gamarrita/fmc-320u-public/altium/FMC-320U-A2/pcbway/comercial invoice/readme.txt

La proforma final tal cual se puede descargar de pcbway, con la que se hizo el pago
