gamarrita/fmc-320u-public/altium/FMC-320U-A2/pcbway/quotations/Quotation T-M10W373821A-2sets-fmc-320-u-a1+-+bom(2023-11-03).xls

PCBWay Bom Quotation, Product No.:T-M10W373821A
Item # | *Designator | *Qty | Manufacturer | *Mfg Part # | Description / Value | *Package/Footprint | Mounting Type | Substitute | *Unit Price(2 sets) | *Total | *Delivery Time | *PCBWay Note | Customer Reply | PCBWay Update
1 | C1, C2, C3, C4, C5, C6, C7, C9, C10, C11, C12, C13, C15, C22 | 14 | Yageo | CC0805KRX7R8BB104 | 100nF | 0805 | Surface Mount, MLCC | CC0805KRX7R9BB104 | $0.015 | $0.420
2 | C8, C19, C23, C24 | 4 | Yageo | CC0805KKX5R8BB106 | 10uF | 0805 | Surface Mount, MLCC |  | $0.084 | $0.672
3 | C14, C17, C18 | 3 | Yageo | CC0805KKX7R8BB225 | 2.2uF | 0805 | Surface Mount, MLCC |  | $0.066 | $0.396
4 | C16 | 1 | Yageo | CC0805KKX7R8BB105 | 1uF | 0805 | Surface Mount, MLCC |  | $0.084 | $0.168
5 | C20, C21 | 2 | Yageo | CC0805JRNPO9BN120 | 12pF | 0805 | Surface Mount, MLCC |  | $0.050 | $0.200
6 | CN1 | 1 | Amphenol ICC | 54101-T0605LF |  |  |  |  | $0.427 | $0.854 | 7-10 Workdays
7 | CN2 | 1 | Dealon | DW254R-22-20-85 |  |  |  |  | $0.677 | $1.354
8 | CN3 | 1 | Dealon | DW254S-22-10-85 |  |  |  |  | $0.715 | $1.430
9 | CN4 | 1 | Amphenol ICC | 20021511-00014T4LF |  |  |  |  | $2.214 | $4.428
10 | ESD1, ESD2, ESD3 | 3 | ST | ESDALC6V1W5 |  |  | Surface Mount |  | $0.339 | $2.034
11 | J3 | 1 | Ckmtw | B-2100S08P-B110 |  |  |  |  | $0.341 | $0.682
12 | L1 | 1 | Murata Electronics | LQM21PN2R2MGHL | 2.2uH |  | Surface Mount |  | $0.252 | $0.504
13 | LD1 | 1 | Everlight Elec | 17-21SYGC/S530-E2/TR8 |  |  |  |  | $0.064 | $0.128
14 | LD2 | 1 | Everlight Elec | 17-21SYGC/S530-E2/TR8 |  |  |  |  | $0.064 | $0.128
15 | LD3 | 1 | Everlight Elec | 17-21/BHC-XL2M2TY/3T |  |  |  |  | $0.093 | $0.186
16 | LSE1 | 1 | Seiko | SC32S-12.5PF20PPM | 32,768 kHz |  |  |  | $0.686 | $1.372 | 7-10 Workdays
17 | PTH1, PTH2, PTH3, PTH4 | 4 |  |  |  |  |  |  |  |  |  | [DNP不要贴];
18 | Q1 | 1 | Diodes Incorporated | DMG3401LSN-7 |  |  | Surface Mount |  | $0.341 | $0.682
19 | R1, R2, R3, R4, R5, R6, R7, R8 | 8 | Yageo | RC0805FR-07100KL | 100K | 0805 |  |  | $0.018 | $0.288
20 | R9 | 1 | Yageo | RC0805FR-071ML | 1M | 0805 |  |  | $0.143 | $0.286
21 | R10, R13, R14, R15, R16, R17, R18, R19 | 8 | Yageo | RC0805FR-0747RL | 47R | 0805 |  |  | $0.017 | $0.272
22 | R11 | 1 | Yageo | RC0805FR-07100RL | 100R | 0805 |  |  | $0.136 | $0.272
23 | R12 | 1 | Yageo | RC0805FR-0710KL | 10K | 0805 |  |  | $0.136 | $0.272
24 | R22, R23, R24 | 3 | Yageo | RC0805FR-071KL | 1K | 0805 |  |  | $0.048 | $0.288
25 | SW1, SW2, SW3, SW4 | 4 | XKB Connectivity | TC-1102-B-A-B |  |  |  |  | $0.099 | $0.792
26 | U1 | 1 | NXP | PCF8553DTT/AY |  |  | Surface Mount |  | $1.284 | $2.568 | 15Workdays
27 | U2 | 1 | ST | STM32U575VIT6Q |  |  | Surface Mount |  | $15.121 | $30.242 | 7-10 Workdays
 |  |  |  |  |  |  |  |  | Component Cost | $50.92
 |  |  |  |  |  |  |  |  | Assembly Cost | $30.00
 |  |  |  |  |  |  |  |  | PCB Cost | $5.00
 |  |  |  |  |  |  |  |  | V0 Member 0% off | $0.00
 |  |  |  |  |  |  |  |  | All Total 2 Sets | $85.92
