gamarrita/fmc-320u-public/altium/FMC-320U-A2/pcbway/quotations/Quotation T-M10W373821A-5sets-fmc-320-u-a1+-+bom(2023-11-02).xls

PCBWay Bom Quotation, Product No.:T-M10W373821A
Item # | *Designator | *Qty | Manufacturer | *Mfg Part # | Description / Value | *Package/Footprint | Mounting Type | Substitute | *Unit Price(5 sets) | *Total | *Delivery Time | *PCBWay Note | Customer Reply | PCBWay Update
1 | C1, C2, C3, C4, C5, C6, C7, C9, C10, C11, C12, C13, C15, C22 | 14 | Yageo | CC0805KRX7R8BB104 | 100nF | 0805 | Surface Mount, MLCC | CC0805KRX7R9BB104 | $0.015 | $1.050
2 | C8, C19, C23, C24 | 4 | Yageo | CC0805KKX5R8BB106 | 10uF | 0805 | Surface Mount, MLCC |  | $0.084 | $1.680
3 | C14, C17, C18 | 3 | Yageo | CC0805KKX7R8BB225 | 2.2uF | 0805 | Surface Mount, MLCC |  | $0.066 | $0.990
4 | C16 | 1 | Yageo | CC0805KKX7R8BB105 | 1uF | 0805 | Surface Mount, MLCC |  | $0.084 | $0.420
5 | C20, C21 | 2 | Yageo | CC0805JRNPO9BN120 | 12pF | 0805 | Surface Mount, MLCC |  | $0.050 | $0.500
6 | CN1 | 1 | Amphenol ICC | 54101-T0605LF |  |  |  |  | $0.427 | $2.135 | 7-10 Workdays
7 | CN2 | 1 | Dealon | DW254R-22-20-85 |  |  |  |  | $0.271 | $1.355
8 | CN3 | 1 | Dealon | DW254S-22-10-85 |  |  |  |  | $0.286 | $1.430
9 | CN4 | 1 | Amphenol ICC | 20021511-00014T4LF |  |  |  |  | $2.214 | $11.070
10 | ESD1, ESD2, ESD3 | 3 | ST | ESDALC6V1W5 |  |  | Surface Mount |  | $0.271 | $4.065
11 | J3 | 1 | Ckmtw | B-2100S08P-B110 |  |  |  |  | $0.341 | $1.705
12 | L1 | 1 | Murata Electronics | LQM21PN2R2MGHL | 2.2uH |  | Surface Mount |  | $0.252 | $1.260
13 | LD1 | 1 | Everlight Elec | 17-21SYGC/S530-E2/TR8 |  |  |  |  | $0.064 | $0.320
14 | LD2 | 1 | Everlight Elec | 17-21SYGC/S530-E2/TR8 |  |  |  |  | $0.064 | $0.320
15 | LD3 | 1 | Everlight Elec | 17-21/BHC-XL2M2TY/3T |  |  |  |  | $0.093 | $0.465
16 | LSE1 | 1 | Seiko | SC32S-12.5PF20PPM | 32,768 kHz |  |  |  | $0.686 | $3.430 | 7-10 Workdays
17 | PTH1, PTH2, PTH3, PTH4 | 4 |  |  |  |  |  |  |  |  |  | [DNP不要贴];
18 | Q1 | 1 | Diodes Incorporated | DMG3401LSN-7 |  |  | Surface Mount |  | $0.341 | $1.705
19 | R1, R2, R3, R4, R5, R6, R7, R8 | 8 | Yageo | RC0805FR-07100KL | 100K | 0805 |  |  | $0.007 | $0.280
20 | R9 | 1 | Yageo | RC0805FR-071ML | 1M | 0805 |  |  | $0.057 | $0.285
21 | R10, R13, R14, R15, R16, R17, R18, R19 | 8 | Yageo | RC0805FR-0747RL | 47R | 0805 |  |  | $0.007 | $0.280
22 | R11 | 1 | Yageo | RC0805FR-07100RL | 100R | 0805 |  |  | $0.055 | $0.275
23 | R12 | 1 | Yageo | RC0805FR-0710KL | 10K | 0805 |  |  | $0.054 | $0.270
24 | R22, R23, R24 | 3 | Yageo | RC0805FR-071KL | 1K | 0805 |  |  | $0.019 | $0.285
25 | SW1, SW2, SW3, SW4 | 4 | XKB Connectivity | TC-1102-B-A-B |  |  |  |  | $0.079 | $1.580
26 | U1 | 1 | NXP | PCF8553DTT/AY |  |  | Surface Mount |  | $1.284 | $6.420 | 15Workdays
27 | U2 | 1 | ST | STM32U575VIT6Q |  |  | Surface Mount |  | $15.121 | $75.605 | 7-10 Workdays
 |  |  |  |  |  |  |  |  | Component Cost | $119.18
 |  |  |  |  |  |  |  |  | Assembly Cost | $30.00
 |  |  |  |  |  |  |  |  | PCB Cost | $5.00
 |  |  |  |  |  |  |  |  | V0 Member 0% off | $0.00
 |  |  |  |  |  |  |  |  | All Total 5 Sets | $154.18
