gamarrita/fmc-320u-public/altium/FMC-320U-A2/pcbway/quotations/T-Z12W373821A-5sets-FMC-320U-A2+-+BOM(2023-11-09).xls

PCBWay Bom Quotation, Product No.:T-Z12W373821A
Item # | *Designator | *Qty | Manufacturer | *Mfg Part # | *Package/Footprint | Mounting Type | *Unit Price(5 sets) | *Total | *Delivery Time | *Actual Purchase Mfg Part # | *PCBWay Note | Customer Reply | PCBWay Update
1 | BH1 | 1 | Keystone Electronics | 2462 |  | PCB, Through Hole | $1.497 | $7.485
2 | BH2 | 1 | Myoung | BS-2032-8KC |  |  |  |  |  |  | It's out of stock. Please recommend substitutes or you can supply this part to us. | Use this: BS-08-B2AA016
3 | C1, C3, C17, C18, C20, C21 | 6 | Yageo | CC0805KRX7R9BB333, CC0805KRX5R6BB475 | 0805 |  | $0.029 | $0.870 |  | CC0805KRX7R9BB333 |  | Use this :CC0805KRX5R6BB475
4 | C2, C4, C9, C10, C12, C13, C14, C15, C16 | 9 | Yageo | CC0805KRX7R8BB104 | 0805 | Surface Mount, MLCC | $0.016 | $0.720
5 | C5 | 1 | Yageo | CC0805JRNPO9BN330 | 0805 | Surface Mount, MLCC | $0.050 | $0.250
6 | C6 | 1 | Yageo | CC0805KKX7R8BB105 | 0805 | Surface Mount, MLCC | $0.084 | $0.420
7 | C7, C8 | 2 | Yageo | CC0805KRX7R8BB473 | 0805 | Surface Mount, MLCC | $0.063 | $0.630
8 | C11 | 1 | Yageo | CC0805KRX7R8BB103 | 0805 | Surface Mount, MLCC | $0.055 | $0.275
9 | CN1, J3, J4, J6, J7 | 5 | Amphenol ICC | 54101-T0602LF |  |  |  |  |  |  | It's out of stock. Please recommend substitutes or you can supply this part to us. | Use this: B-2100S02P-A110
10 | CN6 | 1 | DEALON | DZ254R-22-20-63 |  |  | $0.125 | $0.625
11 | CN8 | 1 | DEALON | DZ254R-22-10-63 |  |  | $0.134 | $0.670 |  | PZ254V-12-10P | Original part is not available, substitute we will supply is PZ254V-12-10P,OK?please confirm | Use this: PZ254V-12-10P
12 | D1, D2, D3, D4, D5, D6 | 6 | onsemi | BAV23S |  | Surface Mount | $0.107 | $3.210
13 | D7 | 1 | Diodes Incorporated | SMBJ24CA |  |  | $0.341 | $1.705
14 | EMC3080-P | 1 | MXCHIP | EMC3080-P |  |  | $4.742 | $23.710 |  | EMC3080-PZI5 | we will supply EMC3080-PZI5,OK?please confirm | DNP
15 | F1 | 1 | Bel Fuse Inc. | 0ZCJ0005FF2E |  | Surface Mount | $0.189 | $0.945 | 7-10 Workdays
16 | J1 | 1 | Amphenol ICC | 54101-T06-00 |  |  | $0.024 | $4.800 |  |  | [moq=200];
17 | J2 | 1 | Amphenol ICC | 54102-T0604LF |  |  |  |  |  |  | It's out of stock. Please recommend substitutes or you can supply this part to us. | Use this: PZ254V-12-8P
18 | J5 | 1 | Amphenol ICC | 54101-T06-00 |  |  | $0.024 | $4.800 |  |  | [moq=200]; | Use this: B-2100S02P-A110
19 | P1, P2 | 2 | Ningbo Kangnex Elec | WJ15EDGVC-3.81-2P |  |  | $0.068 | $0.680
20 | P3, P4, P5 | 3 | Ningbo Kangnex Elec | WJ15EDGVC-3.81-3P |  |  | $0.065 | $0.975
21 | PTH1, PTH2, PTH3, PTH4 | 4 |  |  |  |  |  |  |  |  | DNP?[DNP不要贴]; | DNP
22 | Q1, Q3 | 2 | Diodes Incorporated | DMG3401LSN-7 |  | Surface Mount | $0.375 | $3.750
23 | Q2 | 1 | Diodes Incorporated | DMG3402L-7 |  | Surface Mount | $0.209 | $1.045
24 | R1 | 1 | Yageo | RC0805FR-0710RL | 0805 |  | $0.050 | $0.250
25 | R2 | 1 | Yageo | RC0603FR-070RL | 0805 |  | $0.030 | $0.150
26 | R5, R6, R7, R8, R13, R15, R28, R31 | 8 | Yageo | RC0805FR-071ML | 0805 |  | $0.007 | $0.280
27 | R9, R17, R19, R20, R21, R23, R29 | 7 | Yageo | RC0805FR-07100KL | 0805 |  | $0.008 | $0.280
28 | R10, R14, R25, R27 | 4 | Yageo | RC0805FR-0710KL | 0805 |  | $0.014 | $0.280
29 | R11 | 1 | Yageo | RC0805FR-07220KL | 0805 |  | $0.050 | $0.250
30 | R12, R22, R30 | 3 | Yageo | RC0805FR-071KL | 0805 |  | $0.019 | $0.285
31 | R16 | 1 | Yageo | RC0805FR-07200KL | 0805 |  | $0.073 | $0.365
32 | R18 | 1 | Yageo | RC0603FR-072K49L | 0805 |  | $0.030 | $0.150
33 | R24 | 1 | Yageo | RC0805FR-0782KL | 0805 |  | $0.061 | $0.305
34 | R26 | 1 | Yageo | RC0805FR-0747RL | 0805 |  | $0.055 | $0.275
35 | U1 | 1 | Microchip Tech | MCP6541-E/SN |  |  | $0.733 | $3.665 | 7-10 Workdays
36 | U2 | 1 | Gainsil | GS8044-SR |  |  | $0.396 | $1.980
 |  |  |  |  |  |  | Component Cost | $66.08
 |  |  |  |  |  |  | Assembly Cost | $30.00
 |  |  |  |  |  |  | PCB Cost
 |  |  |  |  |  |  | V0 Member 0% off | $0.00
 |  |  |  |  |  |  | All Total 5 Sets | $96.08
