gamarrita/fmc-320u-public/altium/FMC-320U-A1/00_schematics/fmc-320-u-a1.pdf

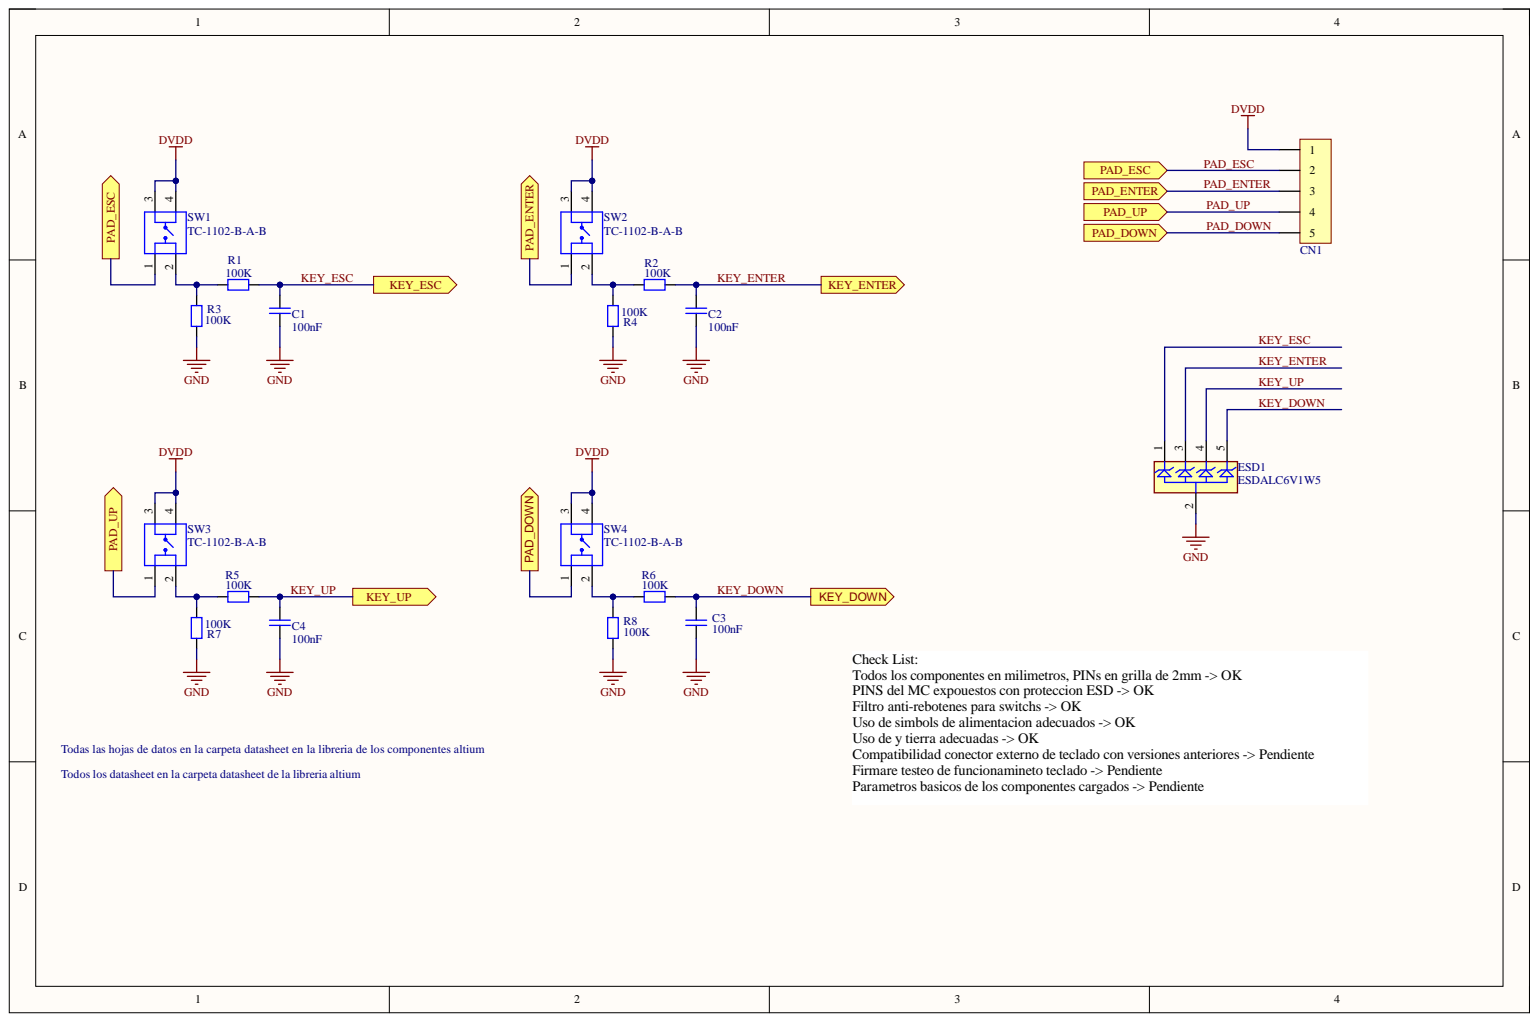
[picture p2: page 1]

s en la carpeta datas

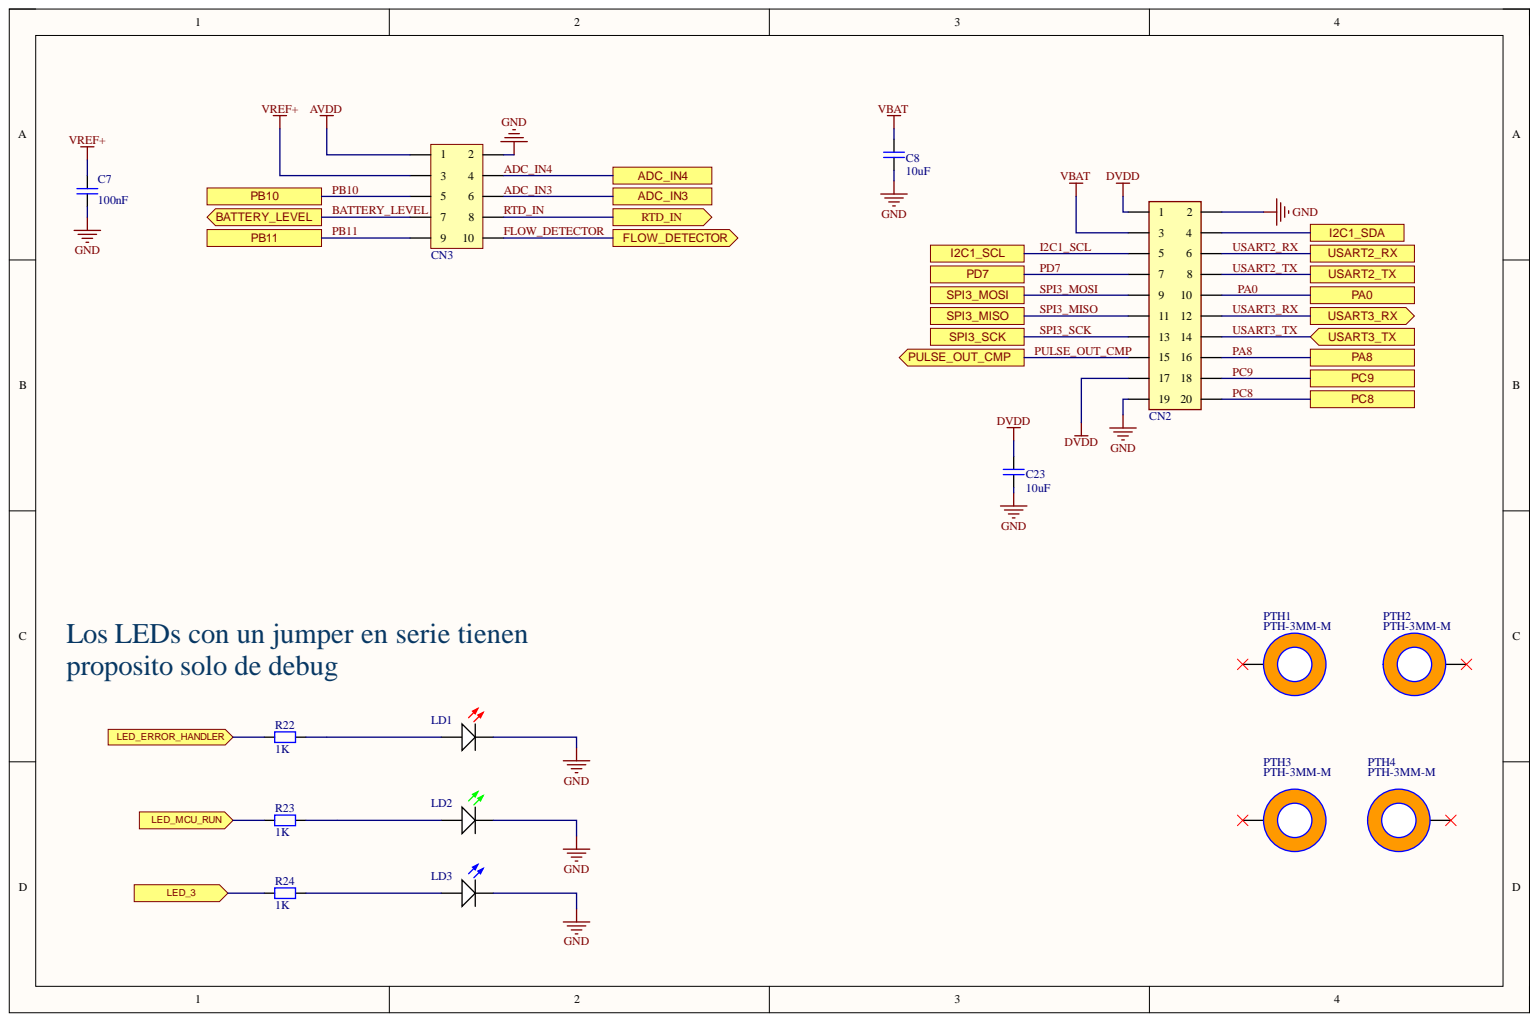
[picture p3: page 2]

Los LEDs con un jumper en serie tienen
proposito solo de debug

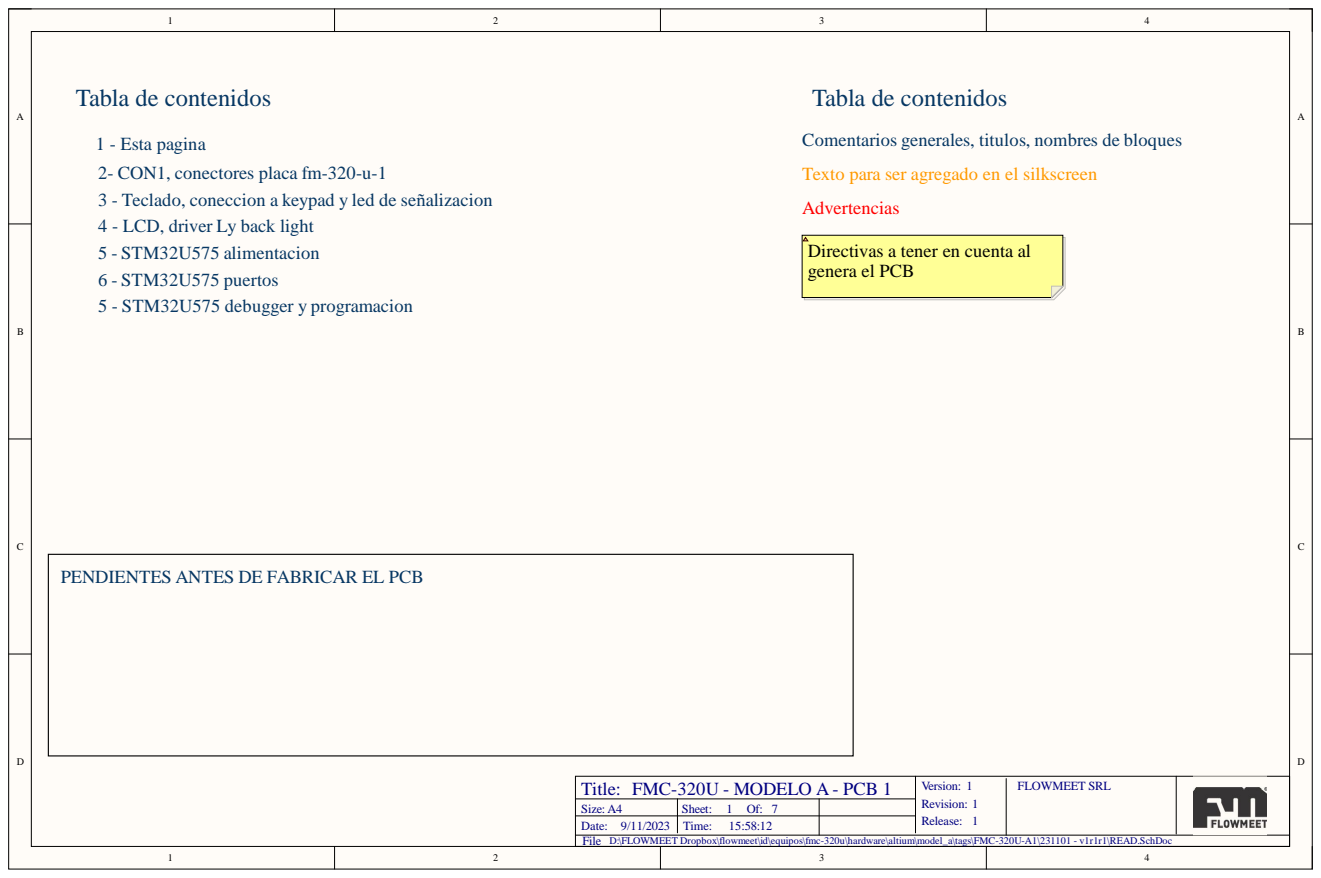
[picture p4: page 3]

1 - Esta pagina
2- CON1, conectores placa fm-320-u-1
3 - Teclado, coneccion a keypad y led de señalizacion
4 - LCD, driver Ly back light
5 - STM32U575 alimentacion
6 - STM32U575 puertos
5 - STM32U575 debugger y programacion

Comentarios generales, titulos, nombres de bloques

Texto para ser agregado en el silkscreen

Directivas a tener en cuenta al
genera el PCB

PENDIENTES ANTES DE FABRICAR EL PCB

Title: FMC-320U - MODELO A - PCB 1 | Version: 1 Revision: 1 Release: 1 | FLOWMEET SRL

Size: A4 | Sheet: 1 Of: 7
Date: 9/11/2023 | Time: 15:58:12

File
D:\FLOWMEET Dropbox\flowmeet\id\equipos\fmc-320u\hardware\altium\model_a\tags\FMC-320U-A1\231101 - v1r1r1\READ.SchDoc

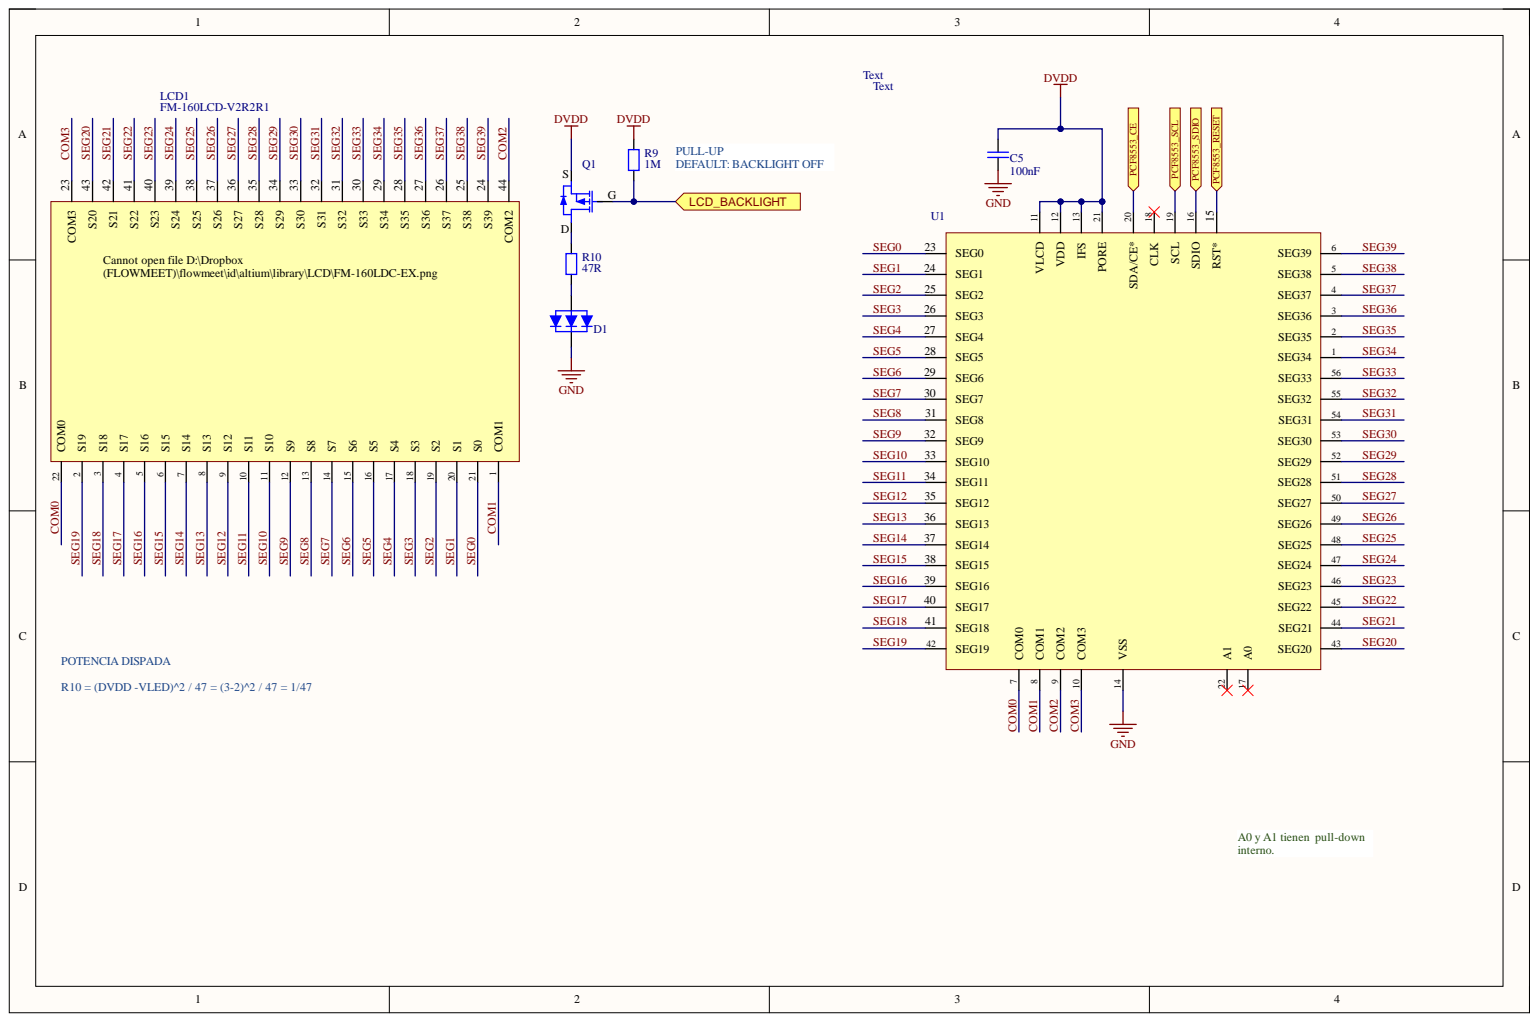
[picture p5: page 4]

Cannot open file D:\Dropbox
(FLOWMEET)\flowmeet\id\altium\library\LCD\FM-160LDC-EX.png

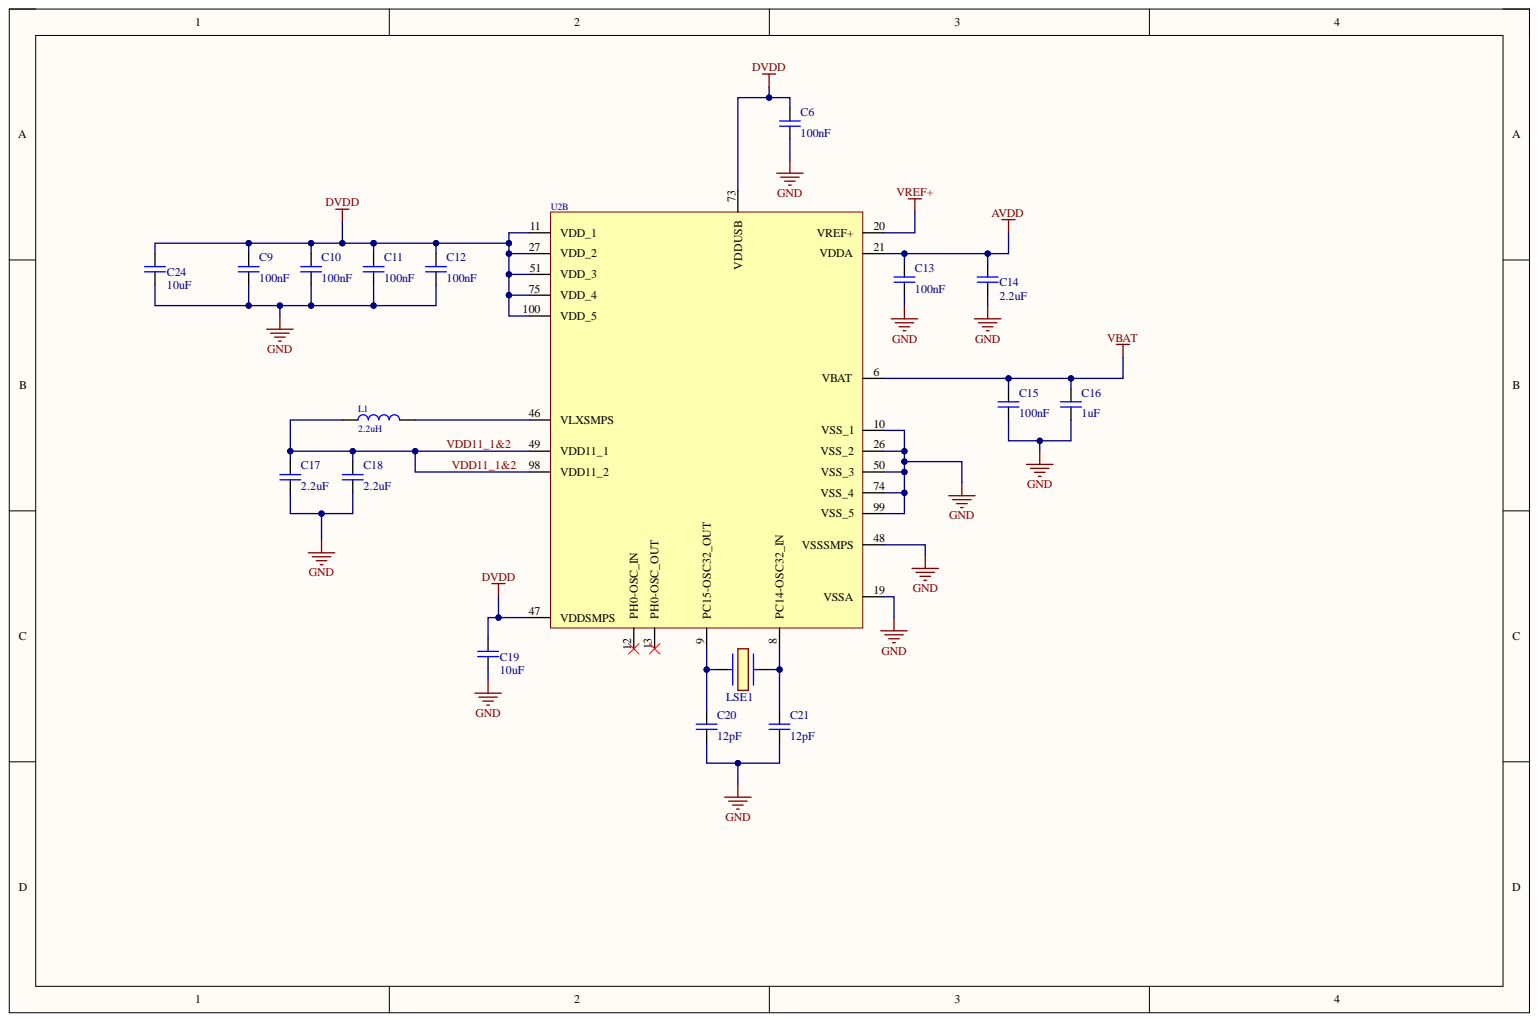
[picture p6: page 5]

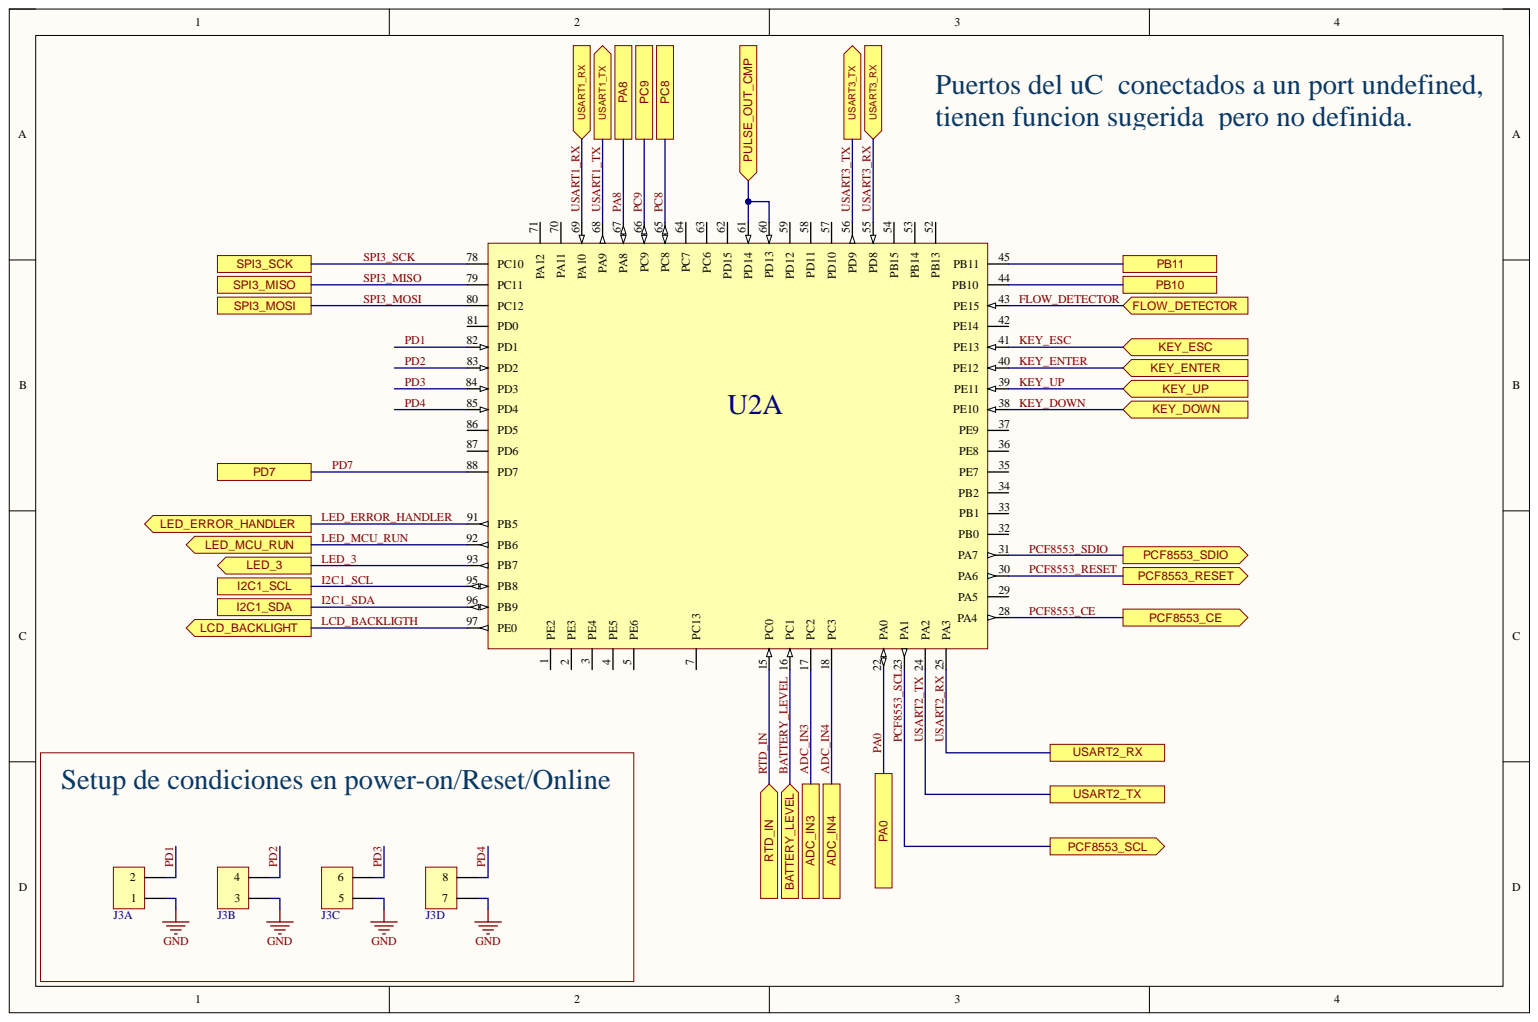
[picture p7: page 6]

USART3_RX
Puertos del uC conectados a un port undefined,
tienen funcion sugerida pero no definida.

Setup de condiciones en power-on/Reset/Online

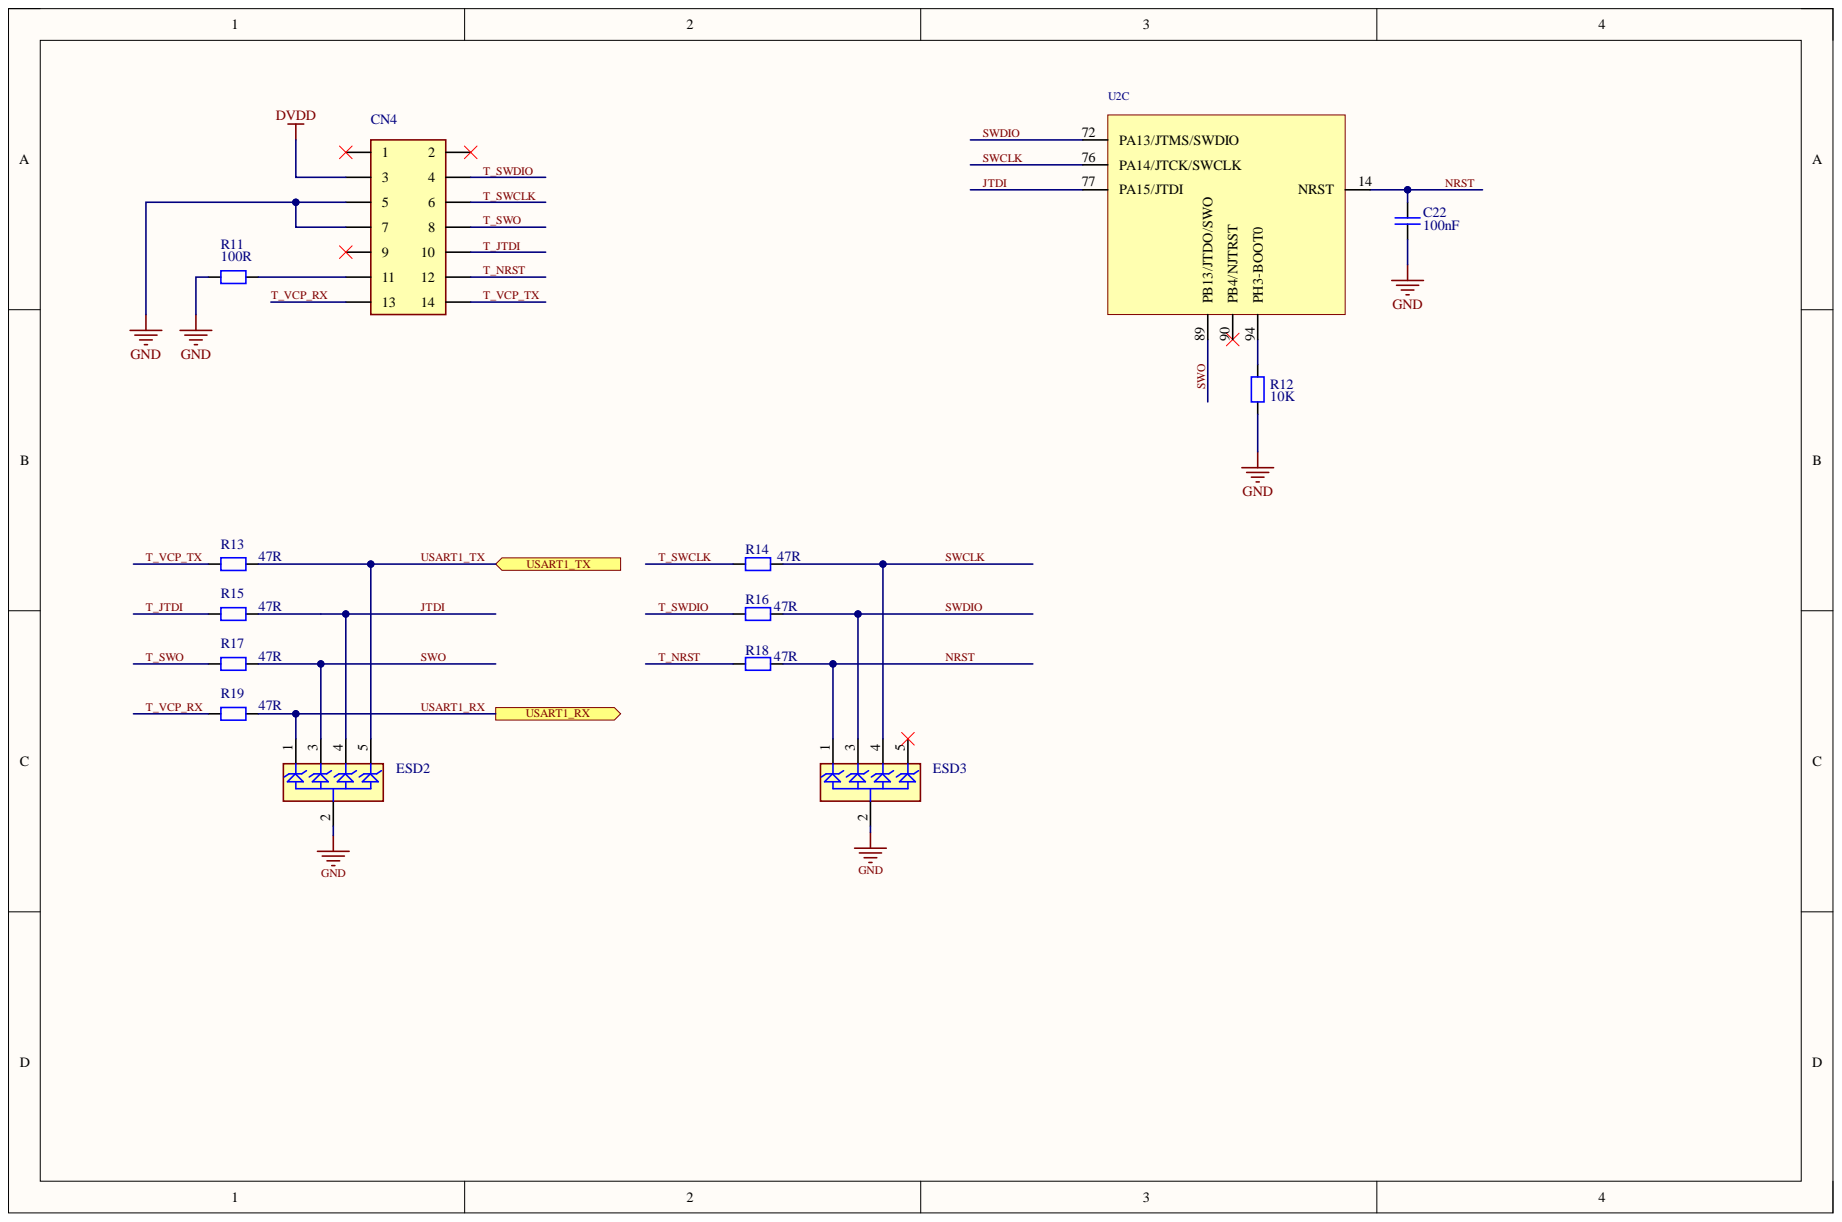
[picture p8: page 7]

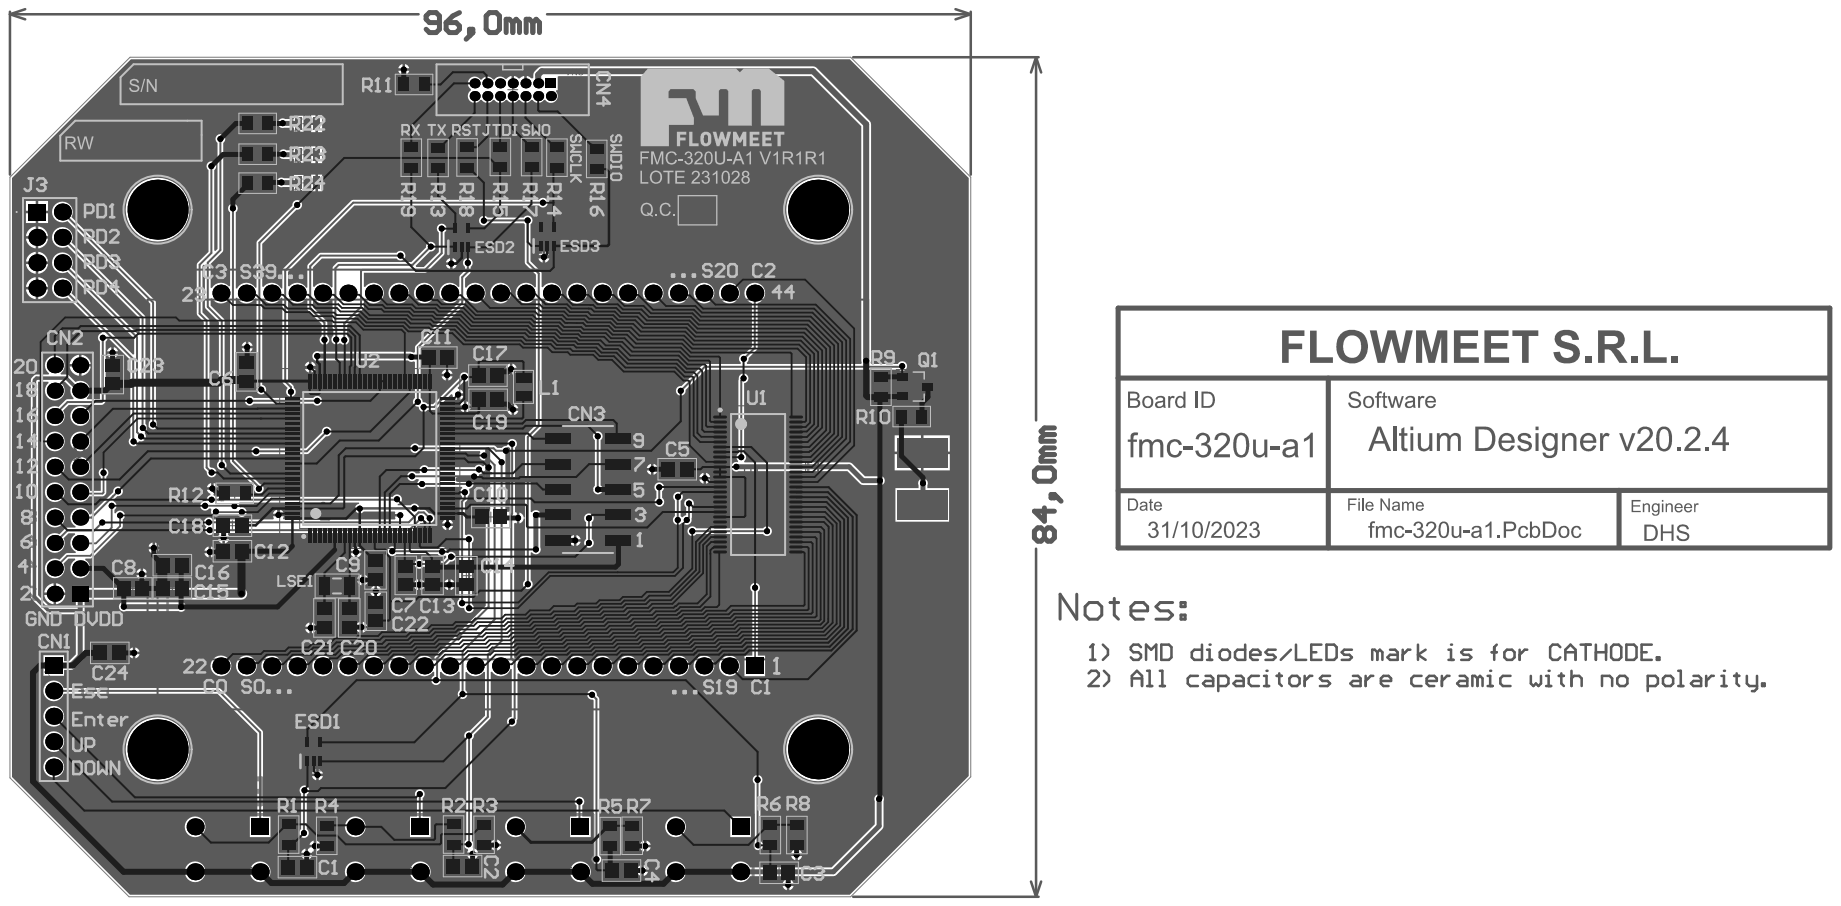
[picture p9: page 8]
