gamarrita/fmc-320u-public/altium/FMC-320U-A2/00_schematics/FMC-320U-A2.pdf

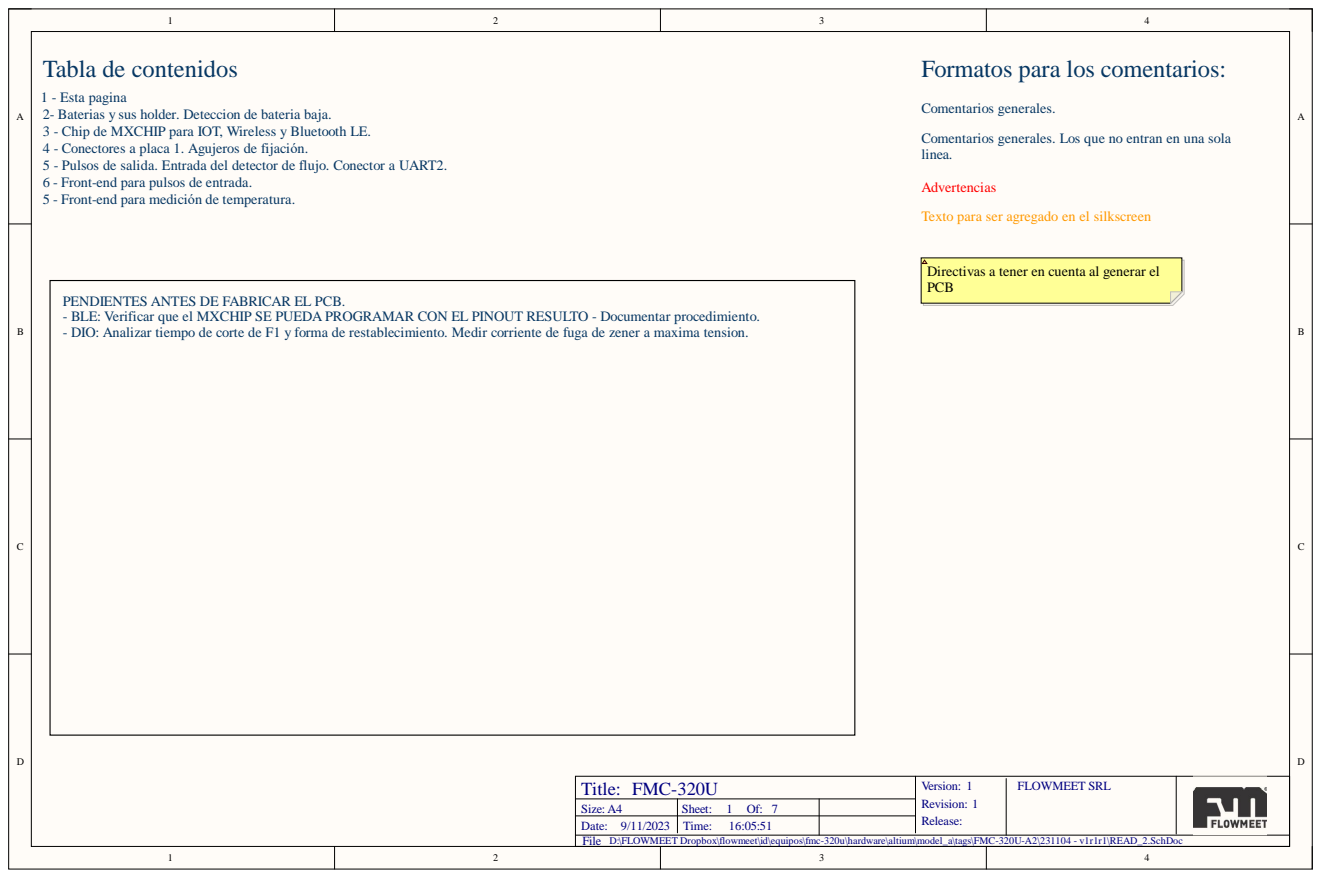
[picture p10: page 1]

1 - Esta pagina
2- Baterias y sus holder. Deteccion de bateria baja.
3 - Chip de MXCHIP para IOT, Wireless y Bluetooth LE.
4 - Conectores a placa 1. Agujeros de fijación.
5 - Pulsos de salida. Entrada del detector de flujo. Conector a UART2.
6 - Front-end para pulsos de entrada.
5 - Front-end para medición de temperatura.

Comentarios generales. Los que no entran en una sola
linea.

Texto para ser agregado en el silkscreen

Directivas a tener en cuenta al generar el
PCB

PENDIENTES ANTES DE FABRICAR EL PCB.
- BLE: Verificar que el MXCHIP SE PUEDA PROGRAMAR CON EL PINOUT RESULTO - Documentar procedimiento.
- DIO: Analizar tiempo de corte de F1 y forma de restablecimiento. Medir corriente de fuga de zener a maxima tension.

Title: FMC-320U | Version: 1 Revision: 1 Release: | FLOWMEET SRL

Size: A4 | Sheet: 1 Of: 7
Date: 9/11/2023 | Time: 16:05:51

File
D:\FLOWMEET Dropbox\flowmeet\id\equipos\fmc-320u\hardware\altium\model_a\tags\FMC-320U-A2\231104 - v1r1r1\READ_2.SchDoc

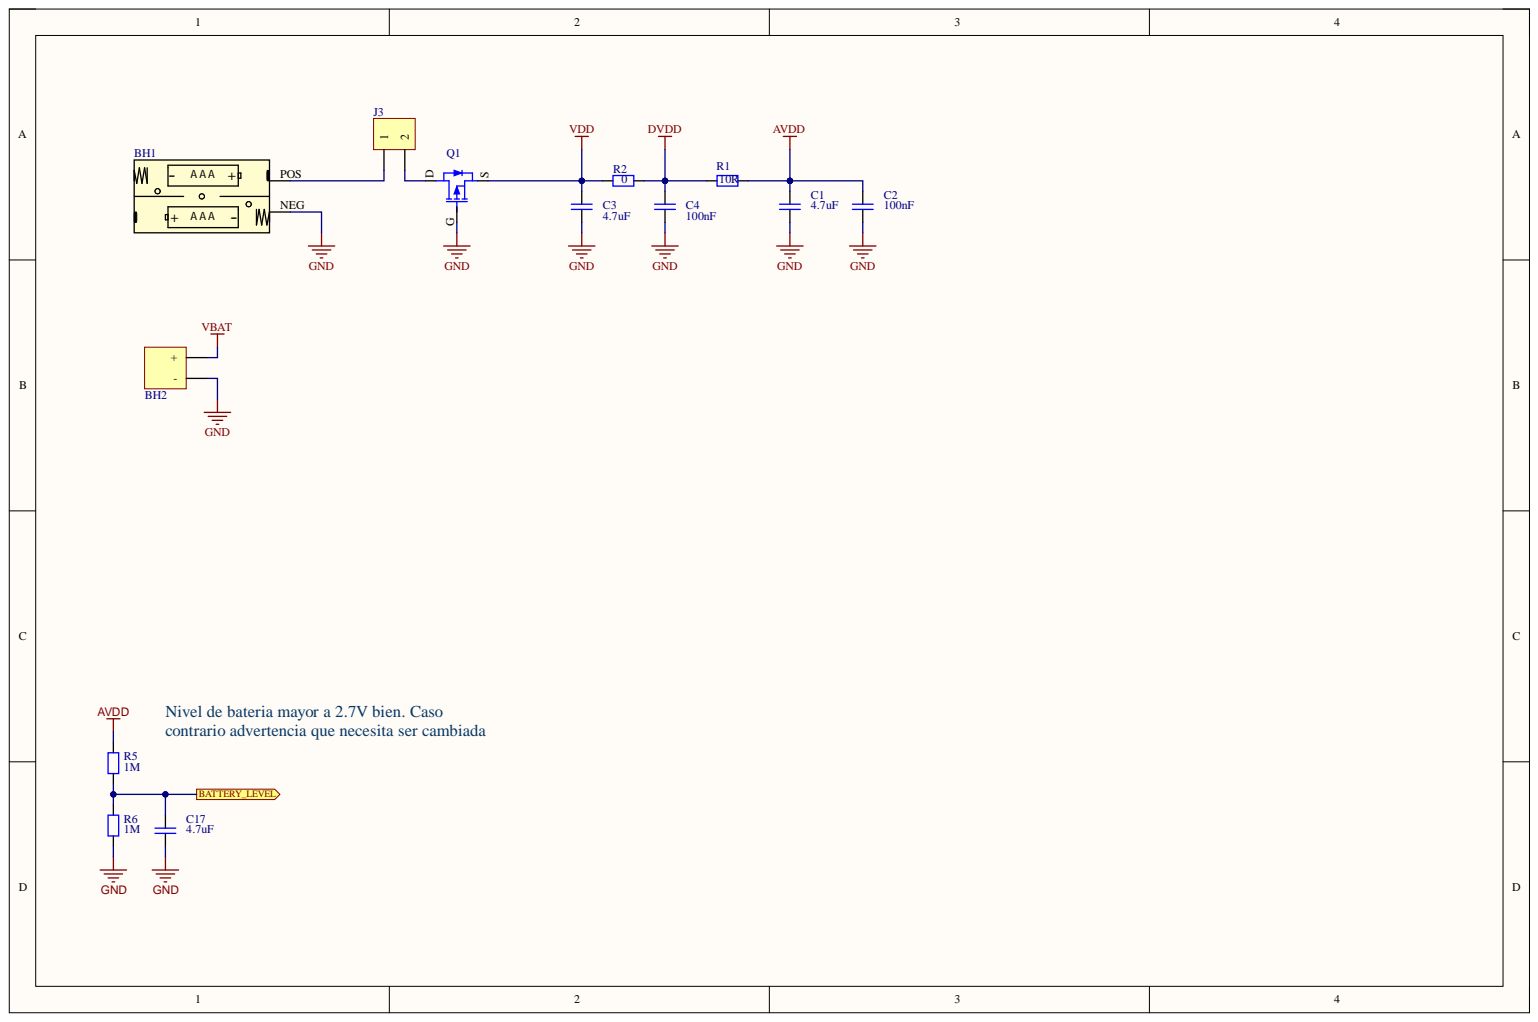
[picture p11: page 2]

Nivel de bateria mayor a 2.7V bien. Caso
contrario advertencia que necesita ser cambiada

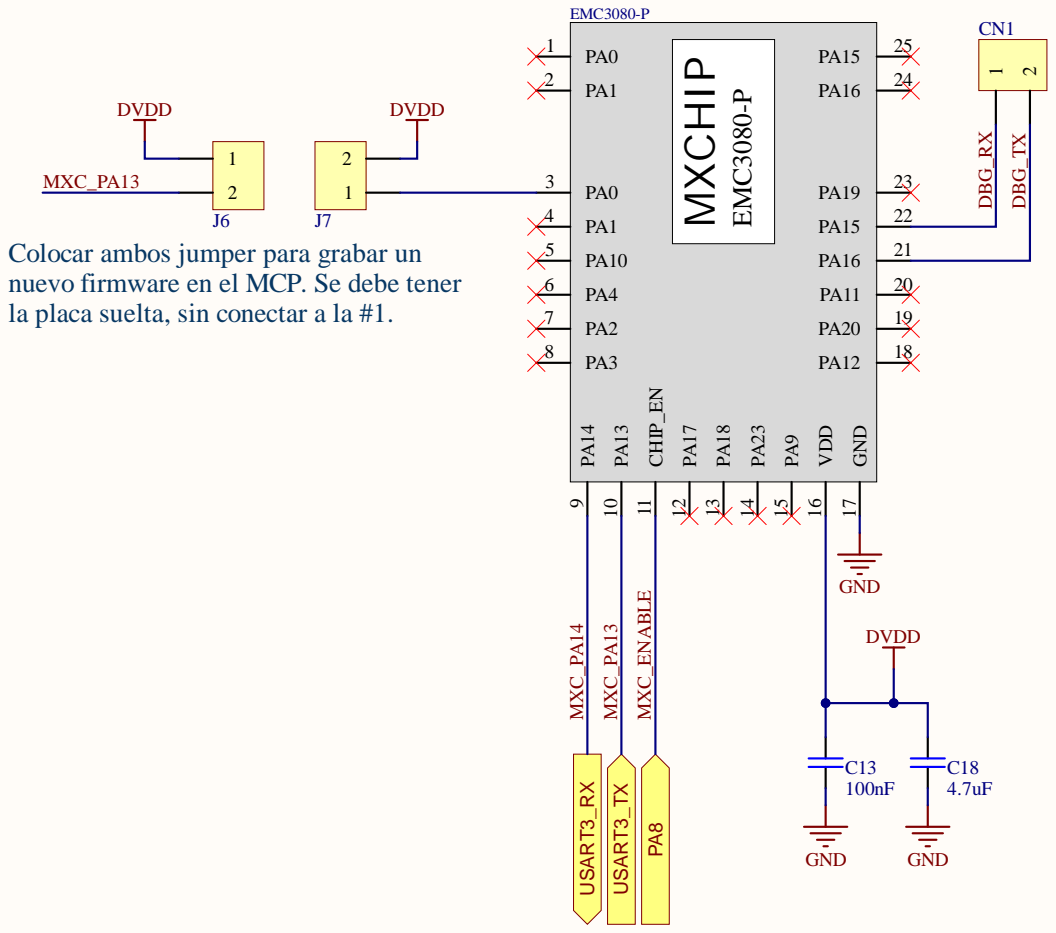
[picture p12: page 3]

Colocar ambos jumper para grabar un
nuevo firmware en el MCP. Se debe tener
la placa suelta, sin conectar a la #1.

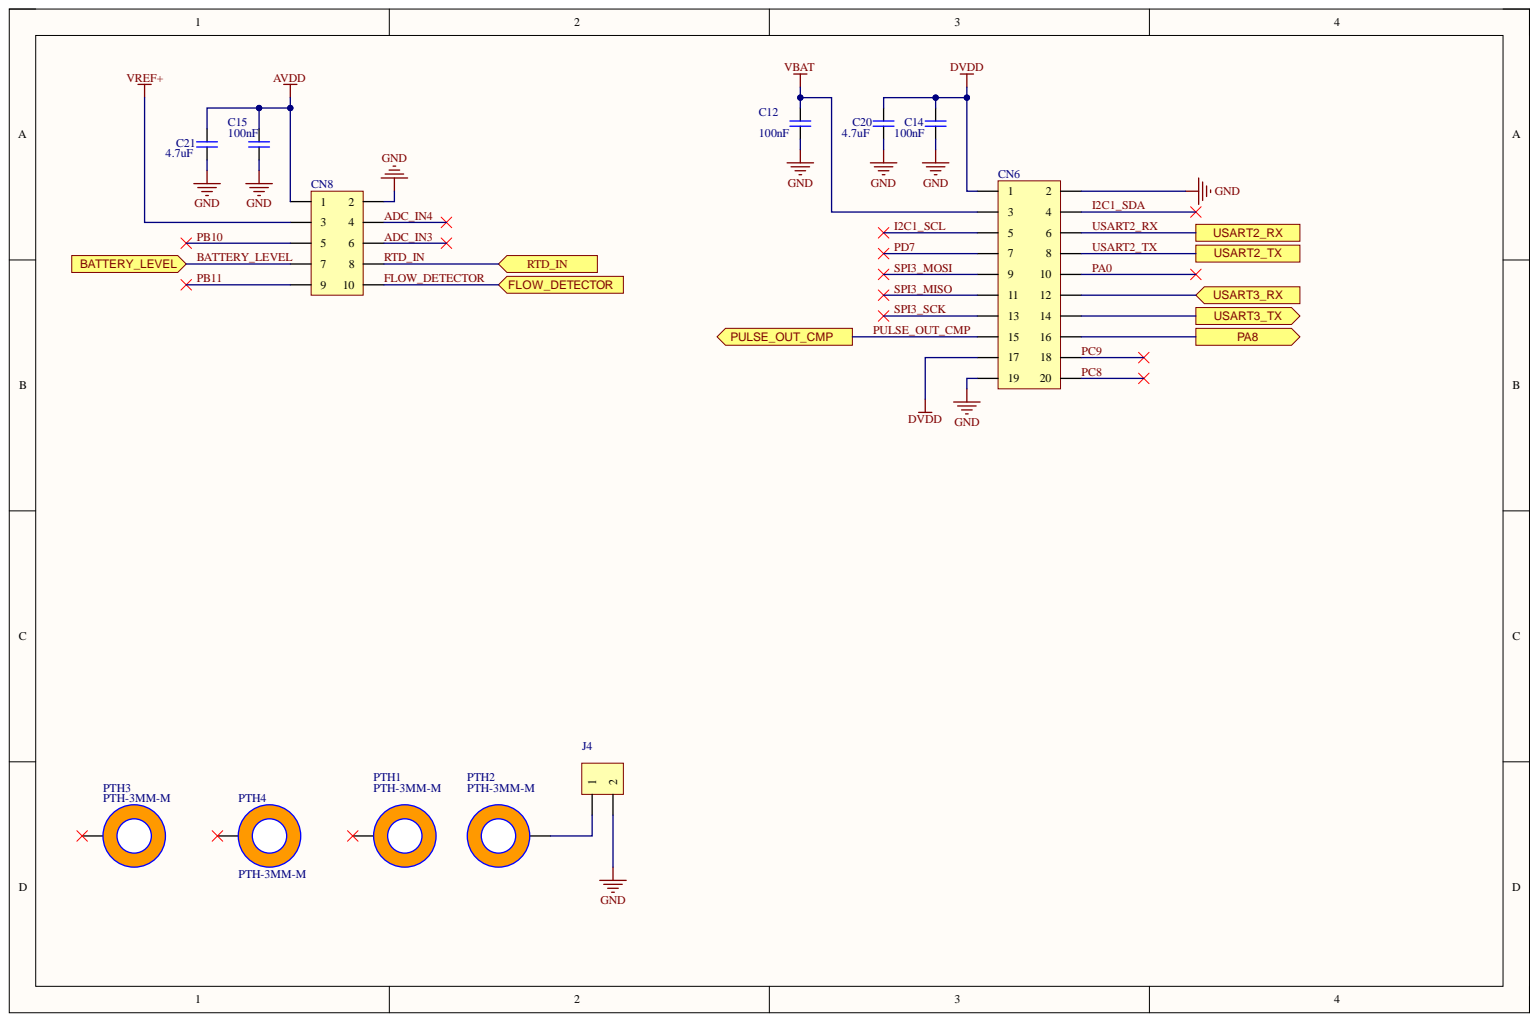
[picture p13: page 4]

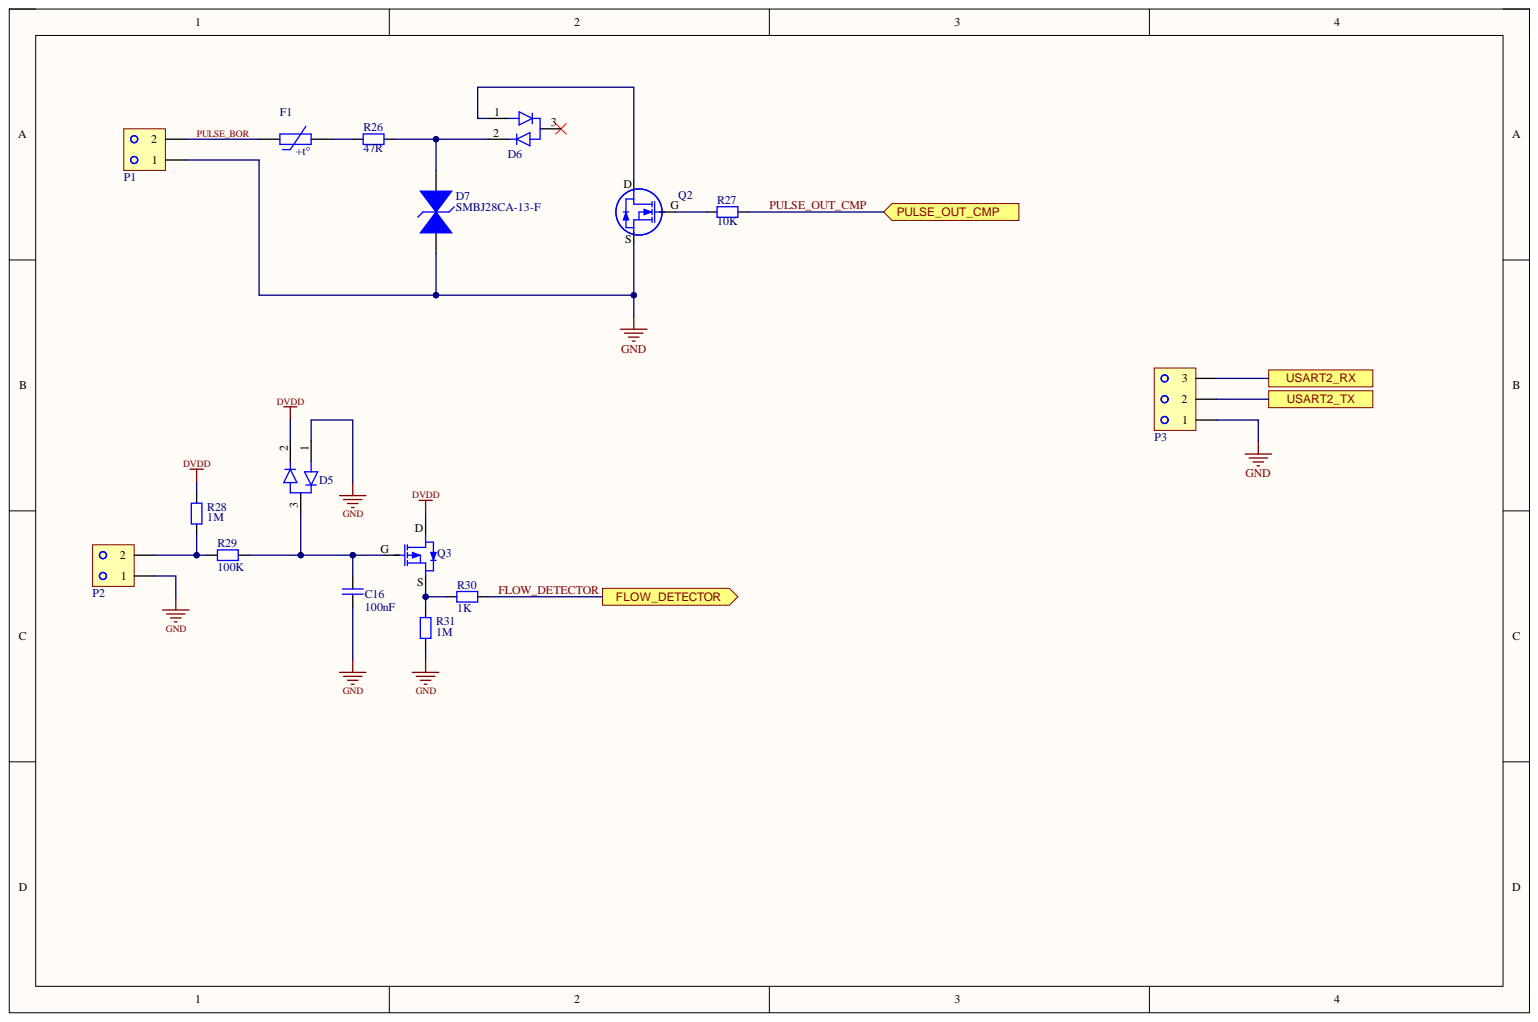
[picture p14: page 5]

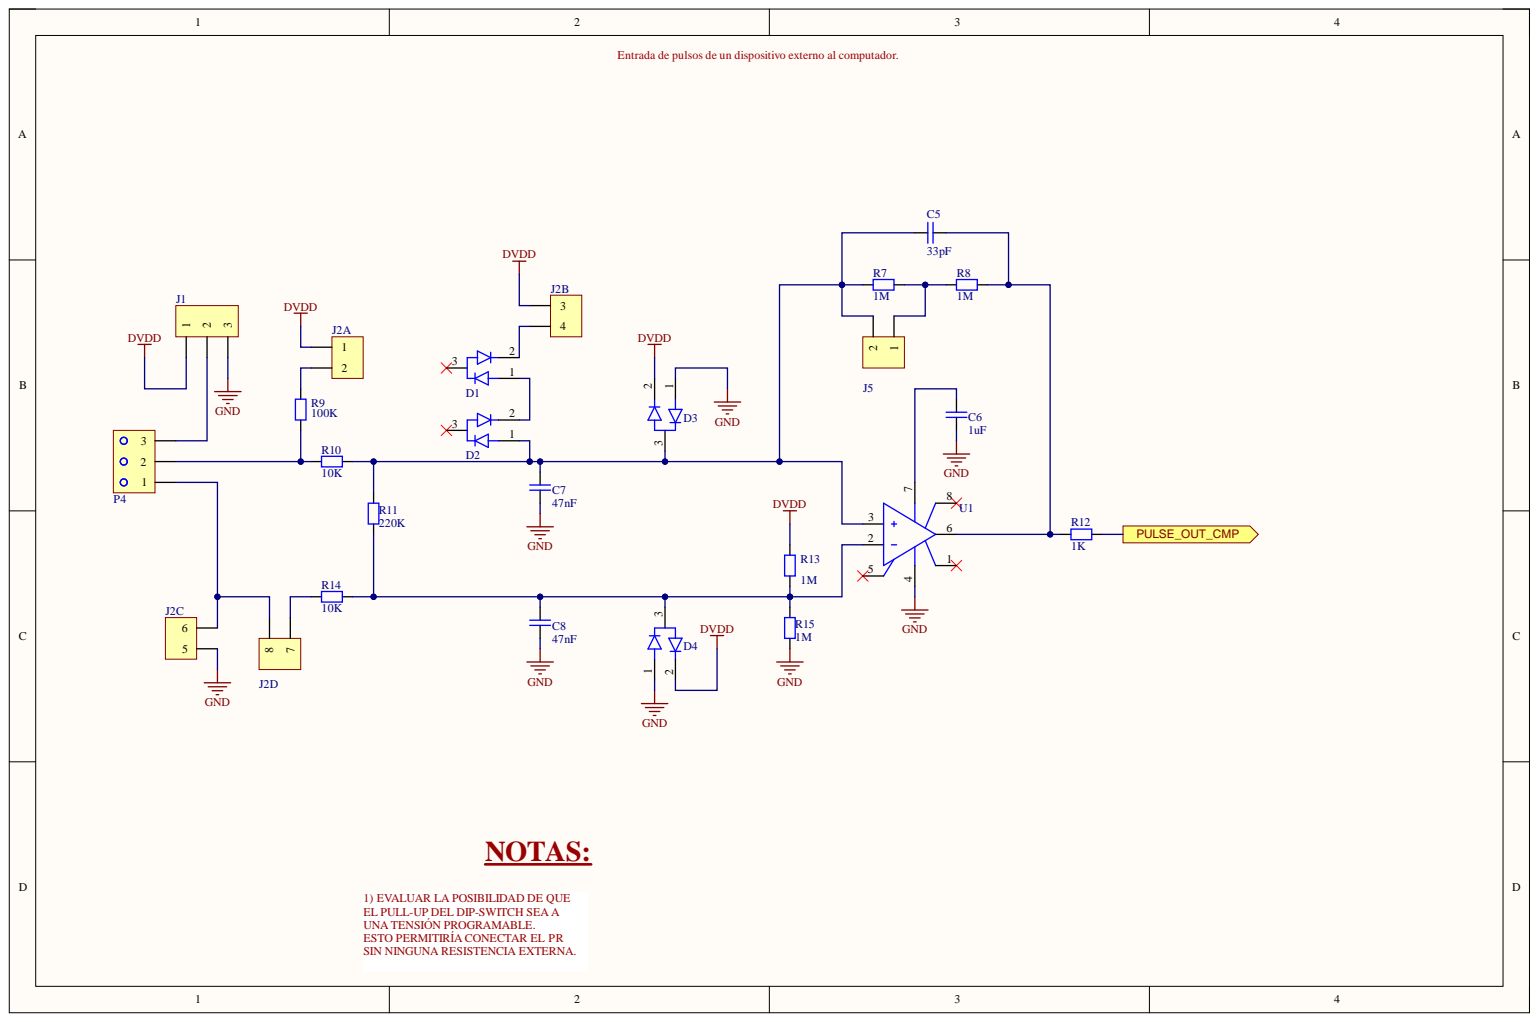
[picture p15: page 6]

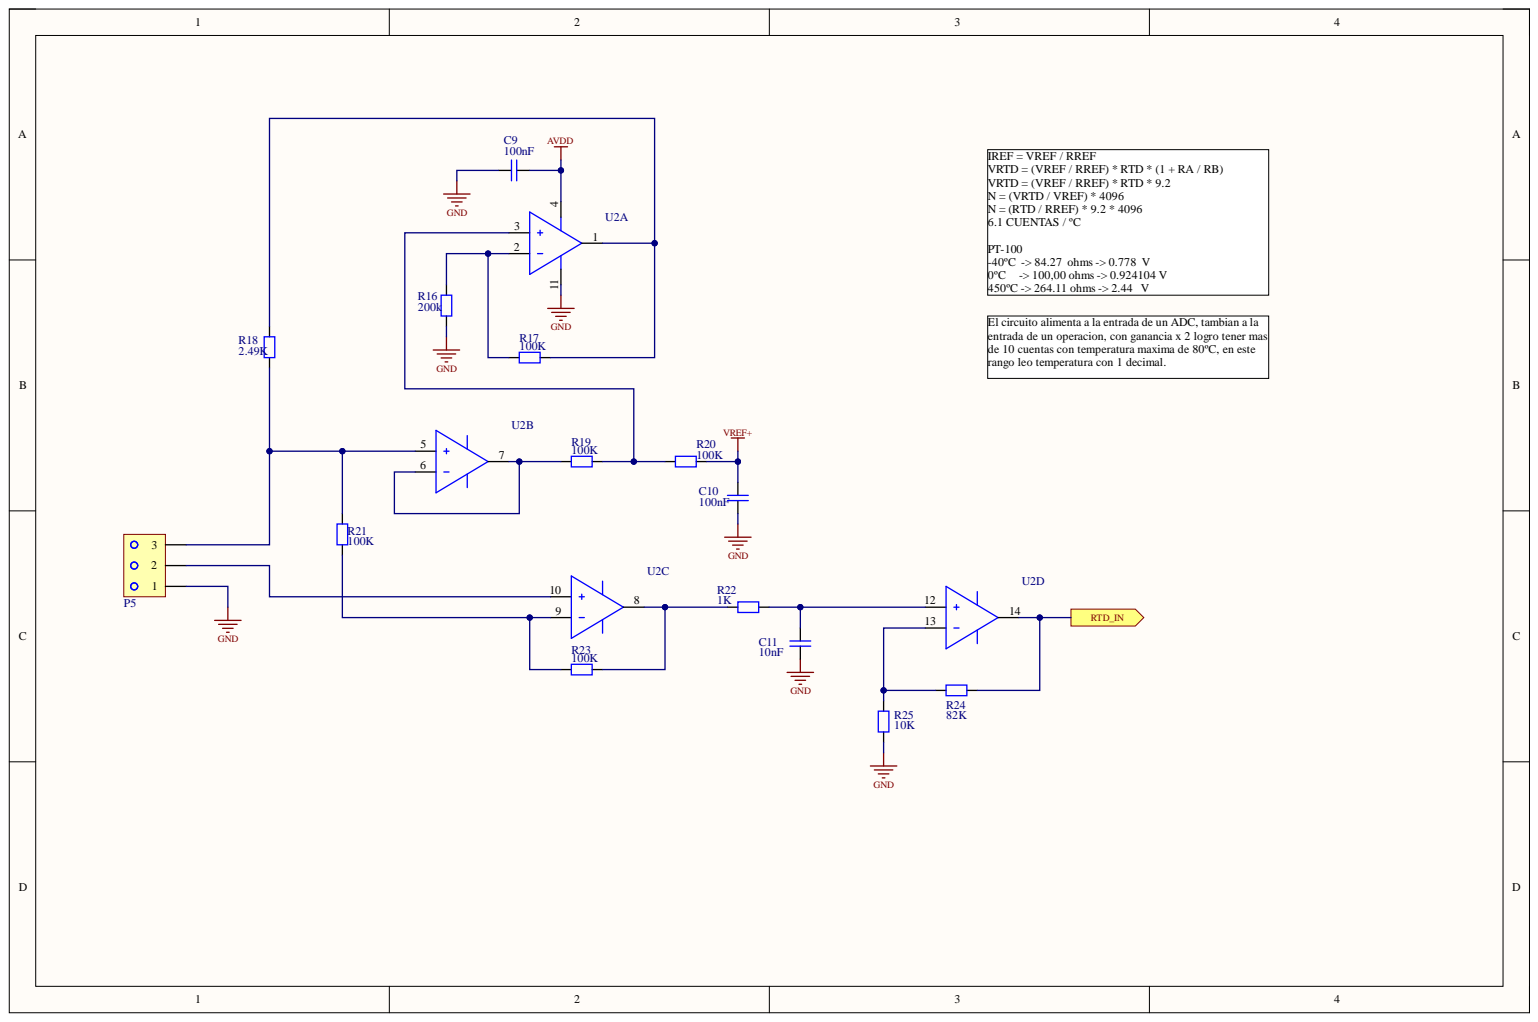
[picture p16: page 7]

IREF = VREF / RREF
VRTD = (VREF / RREF) * RTD * (1 + RA / RB)
VRTD = (VREF / RREF) * RTD * 9.2
N = (VRTD / VREF) * 4096
N = (RTD / RREF) * 9.2 * 4096
6.1 CUENTAS / ºC

El circuito alimenta a la entrada de un ADC, tambian a la
entrada de un operacion, con ganancia x 2 logro tener mas
de 10 cuentas con temperatura maxima de 80ºC, en este
rango leo temperatura con 1 decimal.

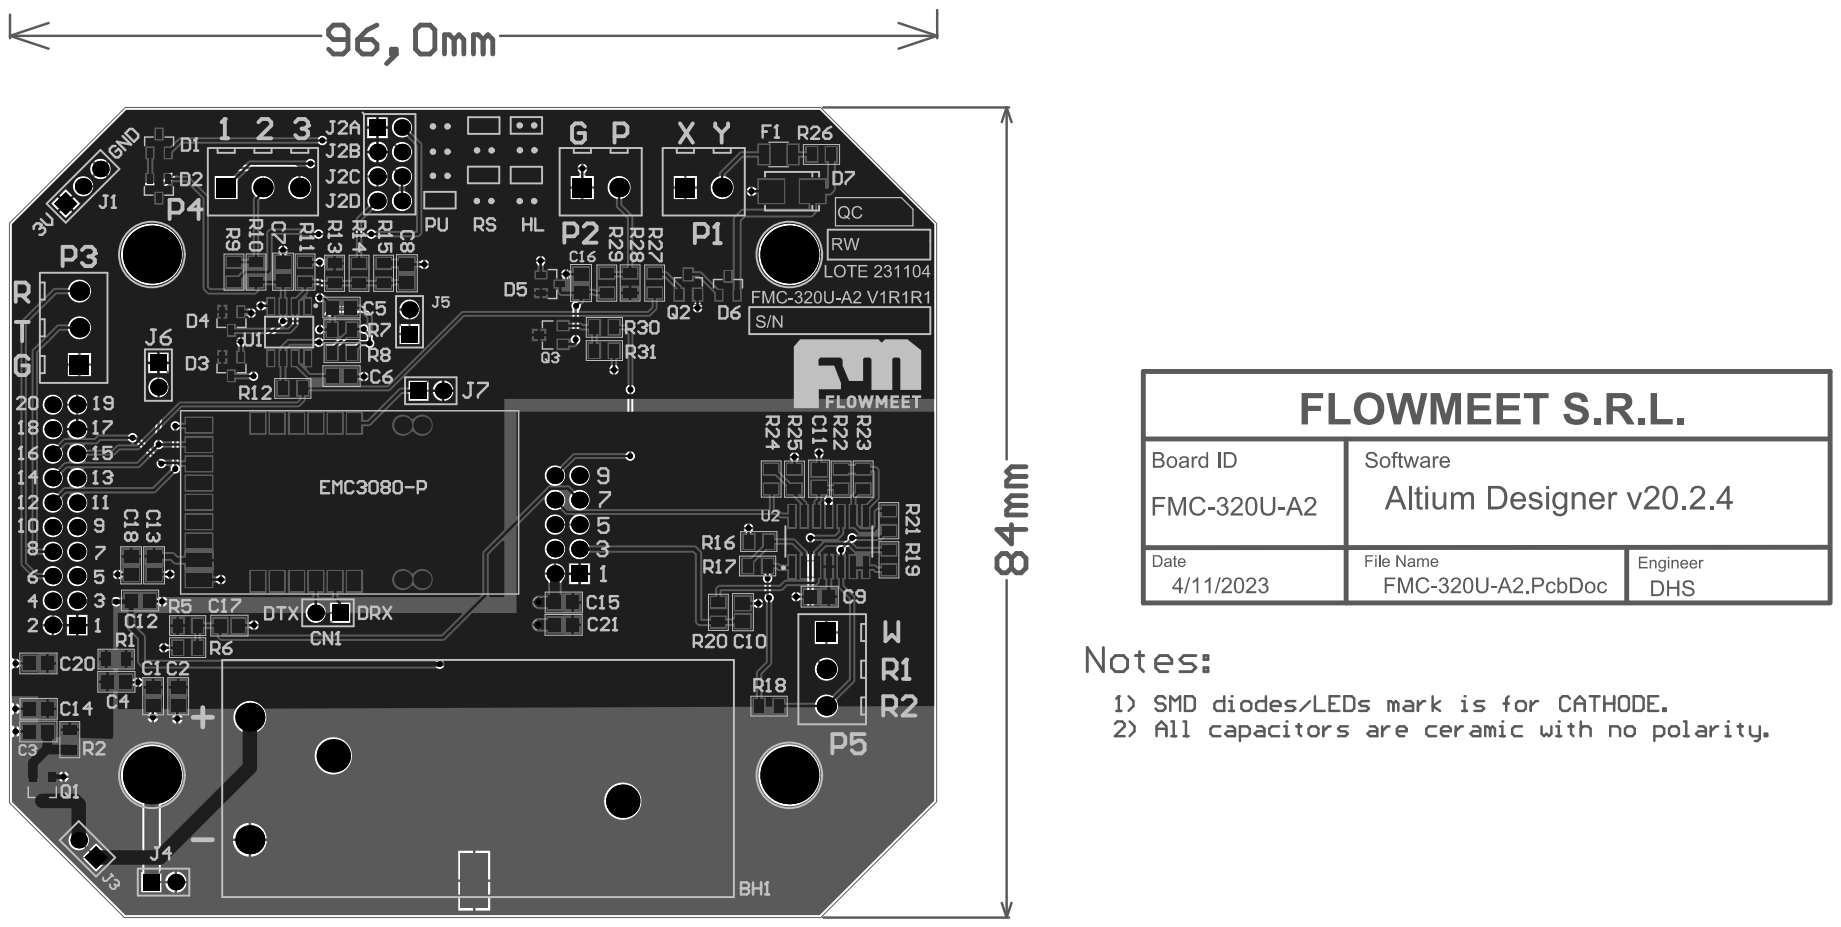
[picture p17: page 8]
