gamarrita/fmc-320u-public/(list of files, drawings)

Other design files:
altium/FMC-320U-A1/CON1.SchDoc
altium/FMC-320U-A1/Dependencies/Capacitores.SchLib
altium/FMC-320U-A1/Dependencies/diode.PcbLib
altium/FMC-320U-A1/Dependencies/diode.SchLib
altium/FMC-320U-A1/Dependencies/FM-160LCD.PcbLib
altium/FMC-320U-A1/Dependencies/FM-160LCD.SchLib
altium/FMC-320U-A1/Dependencies/fuse.PcbLib
altium/FMC-320U-A1/Dependencies/fuse.SchLib
altium/FMC-320U-A1/Dependencies/header_female.PcbLib
altium/FMC-320U-A1/Dependencies/header_female.SchLib
altium/FMC-320U-A1/Dependencies/header_pin.PcbLib
altium/FMC-320U-A1/Dependencies/header_pin.SchLib
altium/FMC-320U-A1/Dependencies/header_shrouded.PcbLib
altium/FMC-320U-A1/Dependencies/header_shrouded.SchLib
altium/FMC-320U-A1/Dependencies/Inductores.PcbLib
altium/FMC-320U-A1/Dependencies/Inductores.SchLib
altium/FMC-320U-A1/Dependencies/LCD_drivers.PcbLib
altium/FMC-320U-A1/Dependencies/LCD_drivers.SchLib
altium/FMC-320U-A1/Dependencies/LED.PcbLib
altium/FMC-320U-A1/Dependencies/LED.SchLib
altium/FMC-320U-A1/Dependencies/Microcontroladores.PcbLib
altium/FMC-320U-A1/Dependencies/Microcontroladores.SchLib
altium/FMC-320U-A1/Dependencies/montaje.PcbLib
altium/FMC-320U-A1/Dependencies/montaje.SchLib
altium/FMC-320U-A1/Dependencies/mosfet.PcbLib
altium/FMC-320U-A1/Dependencies/mosfet.SchLib
altium/FMC-320U-A1/Dependencies/Osciladores.PcbLib
altium/FMC-320U-A1/Dependencies/Osciladores.SchLib
altium/FMC-320U-A1/Dependencies/plug.PcbLib
altium/FMC-320U-A1/Dependencies/plug.SchLib
altium/FMC-320U-A1/Dependencies/Switches.PcbLib
altium/FMC-320U-A1/Dependencies/Switches.SchLib
altium/FMC-320U-A1/Dependencies/Yageo.PcbLib
altium/FMC-320U-A1/Dependencies/Yageo.SchLib
altium/FMC-320U-A1/fmc-320-u-a1.PrjPcb
altium/FMC-320U-A1/fmc-320u-a1.PcbDoc
altium/FMC-320U-A1/KEY.SchDoc
altium/FMC-320U-A1/LCD.SchDoc
altium/FMC-320U-A1/MCU_DBG.SchDoc
altium/FMC-320U-A1/MCU_IO.SchDoc
altium/FMC-320U-A1/MCU_PWR.SchDoc
altium/FMC-320U-A1/READ.SchDoc
altium/FMC-320U-A2/BATTERY.SchDoc
altium/FMC-320U-A2/BLE.SchDoc
altium/FMC-320U-A2/CON2.SchDoc
altium/FMC-320U-A2/Dependencies/Battery_Holders.PcbLib
altium/FMC-320U-A2/Dependencies/Battery_Holders.SchLib
altium/FMC-320U-A2/Dependencies/diode.PcbLib
altium/FMC-320U-A2/Dependencies/diode.SchLib
altium/FMC-320U-A2/Dependencies/fuse.PcbLib
altium/FMC-320U-A2/Dependencies/fuse.SchLib
altium/FMC-320U-A2/Dependencies/header_female.PcbLib
altium/FMC-320U-A2/Dependencies/header_female.SchLib
altium/FMC-320U-A2/Dependencies/header_pin.PcbLib
altium/FMC-320U-A2/Dependencies/header_pin.SchLib
altium/FMC-320U-A2/Dependencies/header_shrouded.PcbLib
altium/FMC-320U-A2/Dependencies/header_shrouded.SchLib
altium/FMC-320U-A2/Dependencies/mechanical.PcbLib
altium/FMC-320U-A2/Dependencies/mechanical.SchLib
altium/FMC-320U-A2/Dependencies/Microcontroladores.PcbLib
altium/FMC-320U-A2/Dependencies/Microcontroladores.SchLib
altium/FMC-320U-A2/Dependencies/montaje.PcbLib
altium/FMC-320U-A2/Dependencies/montaje.SchLib
altium/FMC-320U-A2/Dependencies/mosfet.PcbLib
altium/FMC-320U-A2/Dependencies/mosfet.SchLib
altium/FMC-320U-A2/Dependencies/OP_Amps.PcbLib
altium/FMC-320U-A2/Dependencies/OP_Amps.SchLib
altium/FMC-320U-A2/Dependencies/plug.PcbLib
altium/FMC-320U-A2/Dependencies/plug.SchLib
altium/FMC-320U-A2/Dependencies/Yageo.PcbLib
altium/FMC-320U-A2/Dependencies/Yageo.SchLib
altium/FMC-320U-A2/DIO.SchDoc
altium/FMC-320U-A2/FMC-320U-A2.PcbDoc
altium/FMC-320U-A2/FMC-320U-A2.PrjPcb
altium/FMC-320U-A2/History/00000000C2F0E306/Switches.~(3).SchLib
altium/FMC-320U-A2/History/BATTERY.~(46).SchDoc
altium/FMC-320U-A2/History/BATTERY.~(48).SchDoc
altium/FMC-320U-A2/History/CON2.~(75).SchDoc
altium/FMC-320U-A2/History/CON2.~(78).SchDoc
altium/FMC-320U-A2/History/CON2.~(81).SchDoc
altium/FMC-320U-A2/History/CON2.~(98).SchDoc
altium/FMC-320U-A2/History/CON2.~(99).SchDoc
altium/FMC-320U-A2/History/CON2.~(100).SchDoc
altium/FMC-320U-A2/History/FMC-320U-A2.~(31).PcbDoc
altium/FMC-320U-A2/History/FMC-320U-A2.~(36).PcbDoc
altium/FMC-320U-A2/History/fmc-320u-a-2.~(60).PcbDoc
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
