gamarrita/fmc-320u-public/01_setup/Core/Src/main.c

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
/* Includes ------------------------------------------------------------------*/
#include "main.h"

/* USER CODE BEGIN Includes */
#include "fm_debug.h"

/* USER CODE END Includes */

ADC_HandleTypeDef hadc1;

LPTIM_HandleTypeDef hlptim1;
LPTIM_HandleTypeDef hlptim3;
LPTIM_HandleTypeDef hlptim4;

RTC_HandleTypeDef hrtc;

SPI_HandleTypeDef hspi1;

UART_HandleTypeDef huart1;
UART_HandleTypeDef huart2;

/* USER CODE BEGIN PV */
int  key_counter = 0;


/* USER CODE END PV */

void SystemClock_Config(void);
static void SystemPower_Config(void);
static void MX_GPIO_Init(void);
static void MX_SPI1_Init(void);
static void MX_ADC1_Init(void);
static void MX_ICACHE_Init(void);
static void MX_LPTIM1_Init(void);
static void MX_LPTIM3_Init(void);
static void MX_LPTIM4_Init(void);
static void MX_RTC_Init(void);
static void MX_USART1_UART_Init(void);
static void MX_USART2_UART_Init(void);
/**
  * @brief  The application entry point.
  * @retval int
  */
int main(void)
{
  /* USER CODE BEGIN 1 */

	// El main tiene puede ejecutar diferentes rutinas, main_optio elige una.
	uint8_t main_option = 1;
	char buffer_msg[] = "flowmeet s.r.l.";

	int32_t counter = 0;


  /* USER CODE END 1 */

  /* MCU Configuration--------------------------------------------------------*/

  /* Reset of all peripherals, Initializes the Flash interface and the Systick. */
  HAL_Init();

  /* Configure the system clock */
  SystemClock_Config();

  /* Configure the System Power */
  SystemPower_Config();

  /* Initialize all configured peripherals */
  MX_GPIO_Init();
  MX_SPI1_Init();
  MX_ADC1_Init();
  MX_ICACHE_Init();
  MX_LPTIM1_Init();
  MX_LPTIM3_Init();
  MX_LPTIM4_Init();
  MX_RTC_Init();
  MX_USART1_UART_Init();
  MX_USART2_UART_Init();
  /* Infinite loop */
  /* USER CODE BEGIN WHILE */
  while (1)
  {
	  switch(main_option)
	  {
	  case 1:
		  // Envia un mensaje
		  //fm_debug_msg_uart(buffer_msg, sizeof(buffer_msg));

		  HAL_Delay(1000);
		  break;
	  case 2:
		  counter = key_counter;

		  while(counter == key_counter);

		  fm_debug_int32_uart(key_counter);


		  break;
	  default:
		  break;
	  }

    /* USER CODE END WHILE */

    /* USER CODE BEGIN 3 */
  }
  /* USER CODE END 3 */
}

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
