gamarrita/fmc-320u-public/01_setup/01_setup.ioc

Mcu.UserName=STM32U575VITxQ
PA1.GPIO_Label=PCF8553_SCL
PA1.Signal=SPI1_SCK
PA10.Signal=USART1_RX
PA2.Signal=USART2_TX
PA3.Signal=USART2_RX
PA4.GPIO_Label=PCF8553_CE
PA4.Signal=GPIO_Output
PA6.GPIO_Label=PCF8553_RESET
PA6.Signal=GPIO_Output
PA7.GPIO_Label=PCF8553_SDIO
PA7.Signal=SPI1_MOSI
PA9.Signal=USART1_TX
PB5.GPIO_Label=LED_1_ERROR
PB5.Signal=GPIO_Output
PB6.GPIO_Label=LED_2_ACTIVE
PB6.Signal=GPIO_Output
PB7.GPIO_Label=LED_3_SIGNAL_1
PB7.Signal=GPIO_Output
PB8.GPIO_Label=LCD_BACLLIGHT
PB8.Signal=GPIO_Output
PC0.GPIO_Label=RTD_ADC1_1
PC0.Signal=ADC1_IN1
PC1.GPIO_Label=BATTERY_ADC1_2
PC1.Signal=ADC1_IN2
PC2.Signal=ADC1_IN3
PC3.Signal=ADC1_IN4
PD13.GPIO_Label=PULSE_LPTIM4_IN
PD13.Signal=LPTIM4_IN1
PE10.GPIO_Label=KEY_DOWN
PE10.Signal=GPXTI10
PE11.GPIO_Label=KEY_UP
PE11.Signal=GPXTI11
PE12.GPIO_Label=KEY_ENTER
PE12.Signal=GPXTI12
PE13.GPIO_Label=KEY_ESC
PE13.Signal=GPXTI13
PE15.GPIO_Label=FLOW_DETECTOR
PE15.Signal=GPXTI15
