gamarrita/fmc-320u-public/01_setup/Core/Inc/main.h

#define RTD_ADC1_1_Pin GPIO_PIN_0
#define RTD_ADC1_1_GPIO_Port GPIOC
#define BATTERY_ADC1_2_Pin GPIO_PIN_1
#define BATTERY_ADC1_2_GPIO_Port GPIOC
#define PCF8553_SCL_Pin GPIO_PIN_1
#define PCF8553_SCL_GPIO_Port GPIOA
#define PCF8553_CE_Pin GPIO_PIN_4
#define PCF8553_CE_GPIO_Port GPIOA
#define PCF8553_RESET_Pin GPIO_PIN_6
#define PCF8553_RESET_GPIO_Port GPIOA
#define PCF8553_SDIO_Pin GPIO_PIN_7
#define PCF8553_SDIO_GPIO_Port GPIOA
#define KEY_DOWN_Pin GPIO_PIN_10
#define KEY_DOWN_GPIO_Port GPIOE
#define KEY_DOWN_EXTI_IRQn EXTI10_IRQn
#define KEY_UP_Pin GPIO_PIN_11
#define KEY_UP_GPIO_Port GPIOE
#define KEY_UP_EXTI_IRQn EXTI11_IRQn
#define KEY_ENTER_Pin GPIO_PIN_12
#define KEY_ENTER_GPIO_Port GPIOE
#define KEY_ENTER_EXTI_IRQn EXTI12_IRQn
#define KEY_ESC_Pin GPIO_PIN_13
#define KEY_ESC_GPIO_Port GPIOE
#define KEY_ESC_EXTI_IRQn EXTI13_IRQn
#define FLOW_DETECTOR_Pin GPIO_PIN_15
#define FLOW_DETECTOR_GPIO_Port GPIOE
#define PULSE_LPTIM4_IN_Pin GPIO_PIN_13
#define PULSE_LPTIM4_IN_GPIO_Port GPIOD
#define LED_1_ERROR_Pin GPIO_PIN_5
#define LED_1_ERROR_GPIO_Port GPIOB
#define LED_2_ACTIVE_Pin GPIO_PIN_6
#define LED_2_ACTIVE_GPIO_Port GPIOB
#define LED_3_SIGNAL_1_Pin GPIO_PIN_7
#define LED_3_SIGNAL_1_GPIO_Port GPIOB
#define LCD_BACLLIGHT_Pin GPIO_PIN_8
#define LCD_BACLLIGHT_GPIO_Port GPIOB
