gamarrita/fmc-320u-public/03_threadx/Core/Src/app_threadx.c

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

/* Includes ------------------------------------------------------------------*/
#include "app_threadx.h"

  TX_THREAD tx_app_thread;
  TX_SEMAPHORE tx_app_semaphore;
/**
  * @brief  Application ThreadX Initialization.
  * @param memory_ptr: memory pointer
  * @retval int
  */
UINT App_ThreadX_Init(VOID *memory_ptr)
{
  UINT ret = TX_SUCCESS;
  TX_BYTE_POOL *byte_pool = (TX_BYTE_POOL*)memory_ptr;

CHAR *pointer;

  /* Allocate the stack for tx app thread  */
  if (tx_byte_allocate(byte_pool, (VOID**) &pointer,
                       TX_APP_STACK_SIZE, TX_NO_WAIT) != TX_SUCCESS)
  {
    return TX_POOL_ERROR;
  }
   /* Create tx app thread.  */
  if (tx_thread_create(&tx_app_thread, "tx app thread", tx_app_thread_entry, 0, pointer,
                       TX_APP_STACK_SIZE, TX_APP_THREAD_PRIO, TX_APP_THREAD_PREEMPTION_THRESHOLD,
                       TX_APP_THREAD_TIME_SLICE, TX_APP_THREAD_AUTO_START) != TX_SUCCESS)
  {
    return TX_THREAD_ERROR;
  }

  /* Create tx app semaphore.  */
  if (tx_semaphore_create(&tx_app_semaphore, "tx app semaphore", 0) != TX_SUCCESS)
  {
    return TX_SEMAPHORE_ERROR;
  }

  return ret;
}
/**
  * @brief  Function implementing the tx_app_thread_entry thread.
  * @param  thread_input: Not used.
  * @retval None
  */
void tx_app_thread_entry(ULONG thread_input)
{
  /* USER CODE BEGIN tx_app_thread_entry */
	uint32_t i = 0;
	for(;;)
	{
		if(tx_semaphore_get(&tx_app_semaphore, TX_WAIT_FOREVER) == TX_SUCCESS)
		{
			for(i = 0; i<10; i++)
			{
				HAL_GPIO_TogglePin(LED_3_SIGNAL_1_GPIO_Port, LED_3_SIGNAL_1_Pin);
				App_Delay(50);
			}
		}
	}

  /* USER CODE END tx_app_thread_entry */
}

  /**
  * @brief  MX_ThreadX_Init
  * @param  None
  * @retval None
  */
void MX_ThreadX_Init(void)
{
  tx_kernel_enter();

}

/**
  * @brief  App_ThreadX_LowPower_Timer_Setup
  * @param  count : TX timer count
  * @retval None
  */
void App_ThreadX_LowPower_Timer_Setup(ULONG count)
{
  /* USER CODE BEGIN  App_ThreadX_LowPower_Timer_Setup */

  /* USER CODE END  App_ThreadX_LowPower_Timer_Setup */
}

/**
  * @brief  App_ThreadX_LowPower_Enter
  * @param  None
  * @retval None
  */
void App_ThreadX_LowPower_Enter(void)
{
  /* USER CODE BEGIN  App_ThreadX_LowPower_Enter */
	HAL_GPIO_WritePin(LED_2_ACTIVE_GPIO_Port, LED_2_ACTIVE_Pin, GPIO_PIN_RESET);
	HAL_PWREx_EnterSTOP2Mode(PWR_STOPENTRY_WFI);
  /* USER CODE END  App_ThreadX_LowPower_Enter */
}

/**
  * @brief  App_ThreadX_LowPower_Exit
  * @param  None
  * @retval None
  */
void App_ThreadX_LowPower_Exit(void)
{
  /* USER CODE BEGIN  App_ThreadX_LowPower_Exit */
	HAL_GPIO_WritePin(LED_2_ACTIVE_GPIO_Port, LED_2_ACTIVE_Pin, GPIO_PIN_SET);

  /* USER CODE END  App_ThreadX_LowPower_Exit */
}

/**
  * @brief  App_ThreadX_LowPower_Timer_Adjust
  * @param  None
  * @retval Amount of time (in ticks)
  */
ULONG App_ThreadX_LowPower_Timer_Adjust(void)
{
  /* USER CODE BEGIN  App_ThreadX_LowPower_Timer_Adjust */
  return 0;
  /* USER CODE END  App_ThreadX_LowPower_Timer_Adjust */
}

/* USER CODE BEGIN 1 */
void HAL_GPIO_EXTI_Rising_Callback(uint16_t GPIO_Pin)
{
  ULONG currentValue = 0;
  if (GPIO_Pin == GPIO_PIN_13)
  {
    /* Add additional checks to avoid multiple semaphore puts by successively
    clicking on the user button */
    tx_semaphore_info_get(&tx_app_semaphore, NULL, &currentValue, NULL, NULL, NULL);
    if (currentValue == 0)
    {
      /* Put the semaphore to release the MainThread */
      tx_semaphore_put(&tx_app_semaphore);
    }
  }
}




/* USER CODE END 1 */
